Saanlima/Pepino/README.md

# Pepino
**For further information see the Pepino [Wiki](http://www.saanlima.com/pepino/index.php?title=Welcome_to_Pepino).**
