Saanlima/Pepino/Projects/RISC5Verilog_Pepino_I2C/README.md

Oberon RISC5 for Pepino with I2C controller
===========================================

This is a port of the Oberon RISC5 system for the Pepino FPGA board. Both the LX9 and the LX25 version of Pepino are supported.

The original files can be found at the [Project Oberon page](http://www.projectoberon.com/).

Original Project Oberon design and source code copyright © 1991–2015 Niklaus Wirth (NW) and Jürg Gutknecht (JG)

I2C module copyright © 2016 Magnus Karlsson

For further information see the [Pepino Wiki page](http://www.saanlima.com/pepino/index.php?title=Welcome_to_Pepino).

Changes from the original code
------------------------------
- SD card activity LED added
- I2C controller added

Binaries are available in the ISE folder.
