Saanlima/Pepino/Projects/Pepino_NES_smb/doc/NES_connector.jpg

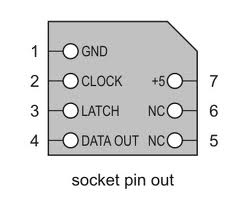
Projects/Pepino_NES_smb/doc/NES_connector.jpg
