Saanlima/Pepino/Board/gerbers_bom/pepino_lx25.xlsx

Pepino LX25 Rev 1.1 BOM
Revision B, 12/08/2015
Line item | Qty | Designators | Description | Package | Type | Manuf. | Part # | DigiKey # | cost | cost for 100 units | Note
1 | 18 | C1 C2 C3 C6 C7 C8 C13 C15 C19 C20 C21 C24 C25 C27 C28 C29 C32 C36 | CAP CER 0.1UF 10V 10% X5R 0402 | C0402 | SMD | Murata | GRM155R61A104KA01D | 490-1318-1-ND | 0.003 | 0.054
2 | 11 | C4 C5 C12 C14 C16 C22 C23 C26 C30 C31 C33 | CAP CER 4.7UF 6.3V 20% X5R 0402 | C0402 | SMD | TDK | C1005X5R0J475M | 445-7395-1-ND | 0.04396 | 0.48356
3 | 2 | C9 C10 | CAP CER 22PF 50V NPO 0402 | C0402 | SMD | Yageo | CC0402JRNPO9BN220 | 311-1018-1-ND | 0.0057 | 0.0114
4 | 2 | C11 C18 | CAP CER 22UF 6.3V 20% X5R 0805 | C0805 | SMD | Taiyo Yuden | JMK212BJ226MG-T | 587-1305-1-ND | 0.112 | 0.224
5 | 1 | C17 | CAP CER 4.7UF 10V X5R 0603 | C0603 | SMD | Yageo | CC0603KRX5R6BB475 | 311-1455-1-ND | 0.0453 | 0.0453
6 | 2 | C34 C35 | CAP CER 4700PF 25V 10% X7R 0402 | C0402 | SMD | Murata | GRM155R71E472KA01D | 490-1309-1-ND | 0.0096 | 0.0192
7 | 1 | F1 | PTC RESTTBLE 0.50A 8V CHIP 1206 | F1206 | SMD | Bel Fuse | 0ZCA0050FF2G | 507-1480-1-ND | 0.1694 | 0.1694
8 | 0 | J1 | Connector Header 8 Position 0.100" Gold Through Hole | MA04-2 | TH | Sullins | PPPC042LFBN-RC | S7107-ND | 0.528 | 0 | Do not mount
9 | 1 | J2 | CONN MINI MICRO-SD 8PIN PCB GOLD | MICRO-SD | SMD | Amphenol | 101-00660-68-6 | 101-00660-68-6-1-ND | 1.4137 | 1.4137
10 | 1 | J3 | CONN JACK STEREO 3.5MM SMD | AUDIO-JACK3 | SMD | Switchcraft | 35RASMT2BHNTRX | SC1489-1-ND | 0.66 | 0.66
11 | 2 | J4 J5 | CONN MINIDIN RECPT UNSHIELD 6POS | MINI-DIN6PTH | TH | CUI | MD-60S | CP-2460-ND | 0.7763 | 1.5526
12 | 1 | J6 | D-Sub Connector, Female 15 Pos Through Hole, Right Angle | DB15H | TH | AMP | 1734344-1 | A35119-ND | 1.04 | 1.04
13 | 1 | J7 | Connector Header 8 Position 0.100" Gold Through Hole | MA04-2 | TH | Sullins | PPPC042LFBN-RC | S7107-ND | 0.528 | 0.528
14 | 1 | J8 | Connector Header 20 Position 0.100" Gold Through Hole | MA10-2 | TH | Sullins | PPPC102LFBN-RC | S6106-ND | 0.9342 | 0.9342
15 | 1 | J9 | CONN RECEPT MINI-USB TYPE B SMT | USB-MINIB-5PIN | SMD | Mill-Max | 897-43-005-00-100001 | ED90341CT-ND | 0.925 | 0.925
16 | 2 | L1 L2 | FERRITE CHIP 600 OHM 200MA 0402 | FB0402 | SMD | Murata | BLM15BD601SN1D | 490-1009-1-ND | 0.047 | 0.094
17 | 1 | L3 | FERRITE CHIP 120 OHM 300MA 0402 | FB0402 | SMD | Murata | BLM15BD121SN1D | 490-5192-1-ND | 0.047 | 0.047
18 | 9 | LD1 LD2 LD3 LD4 LD5 LD6 LD7 LD8 LD9 | LED GREEN CLEAR 0805 SMD | LED0805 | SMD | Lite-On | LTST-C170KGKT | 160-1414-1-ND | 0.06295 | 0.56655
19 | 1 | LD10 | LED SUPER RED CLEAR 0805 SMD | LED0805 | SMD | Lite-On | LTST-C170KRKT | 160-1415-1-ND | 0.1307 | 0.1307
20 | 1 | LD11 | LED YELLOW CLEAR 0805 SMD | LED0805 | SMD | Lite-On | LTST-C170KSKT | 160-1416-1-ND | 0.1307 | 0.1307
21 | 4 | R1 R3 R4 R5 | RES 10.0K OHM 1/10W 1% 0402 SMD | R0402 | SMD | Panasonic | ERJ-2RKF1002X | P10.0KLCT-ND | 0.011 | 0.044
22 | 1 | R2 | RES 12.0K OHM 1/10W 1% 0402 SMD | R0402 | SMD | Panasonic | ERJ-2RKF1202X | P12.0KLCT-ND | 0.011 | 0.011
23 | 1 | R6 | RES 2.20K OHM 1/10W 1% 0402 SMD | R0402 | SMD | Panasonic | ERJ-2RKF2201X | P2.20KLCT-ND | 0.011 | 0.011
24 | 4 | R7 R11 R12 R13 | RES 270 OHM 1/10W 1% 0402 SMD | R0402 | SMD | Panasonic | ERJ-2RKF2700X | P270LCT-ND | 0.011 | 0.044
25 | 3 | R8 R10 R23 | RES 4.70K OHM 1/10W 1% 0402 SMD | R0402 | SMD | Panasonic | ERJ-2RKF4701X | P4.70KLCT-ND | 0.011 | 0.033
26 | 14 | R9 R14 R15 R16 R17 R18 R19 R20 R21 R22 R25 R28 R34 R37 | RES 1.00K OHM 1/10W 1% 0402 SMD | R0402 | SMD | Panasonic | ERJ-2RKF1001X | P1.00KLCT-ND | 0.00496 | 0.06944
27 | 2 | R24 R27 | RES SMD 2K OHM 1% 1/10W 0402 | R0402 | SMD | Panasonic | ERJ-2RKF2001X | P2.00KLCT-ND | 0.011 | 0.022
28 | 2 | R26 R29 | RES 560 OHM 1/10W 1% 0402 SMD | R0402 | SMD | Panasonic | ERJ-2RKF5600X | P560LCT-ND | 0.011 | 0.022
29 | 1 | R30 | RES 820 OHM 1/10W 1% 0402 SMD | R0402 | SMD | Panasonic | ERJ-2RKF8200X | P820LCT-ND | 0.011 | 0.011
30 | 1 | R31 | RES 390 OHM 1/10W 1% 0402 SMD | R0402 | SMD | Panasonic | ERJ-2RKF3900X | P390LCT-ND | 0.011 | 0.011
31 | 2 | R32 R33 | RES 100 OHM 1/10W 1% 0402 SMD | R0402 | SMD | Panasonic | ERJ-2RKF1000X | P100LCT-ND | 0.011 | 0.022
32 | 2 | R35 R36 | RES 3.30K OHM 1/10W 1% 0402 SMD | R0402 | SMD | Panasonic | ERJ-2RKF3301X | P3.30KLCT-ND | 0.011 | 0.022
33 | 1 | S1 | SWITCH DIP SPST EXT ACT 8POS 24V | DIP-SMD | SMD | Alcoswitch | 1-1825058-9 | 1-1825058-9-ND | 0.586 | 0.586
34 | 1 | S2 | SWITCH TACTILE SPST-NO 0.05A 12V | 5.2x5.2 | SMD | C&K | PTS525SM10SMTR LFS | CKN9104CT-ND | 0.513 | 0.513
35 | 1 | U1 | OSCILLATOR 50.0000MHZ SMD | 2.5X2 | SMD | AVX/Kyocera | KC2520B50.0000C10E00 | 478-6302-1-ND | 1.6065 | 1.6065
36 | 1 | U2 | IC FLASH 128MBIT SO8W | SO8-WIDE | SMD | Micron | N25Q128A13ESE40 | N25Q128A13ESE40E-ND | 1.348 | 1.348
37 | 2 | U3 U9 | IC SRAM 8MBIT 10NS 44TSOP | TSOP44 | SMD | ISSI | IS61WV51216BLL-10TLI | 706-1107-ND | 11.5702 | 23.1404
38 | 1 | U4 | IC FPGA 186 I/O 256FTBGA | 6SLX25FTG256 | SMD | Xilinx | XC6SLX25-2FTG256C | 122-1753-ND | 34.02 | 34.02
39 | 1 | U5 | IC REG LDO 3.3V 1A SOT223-3 | SOT223 | SMD | Diodes | ZLDO1117G33TA | ZLDO1117G33DICT-ND | 0.3179 | 0.3179
40 | 1 | U6 | IC REG LDO 1.2V 1A SOT223-3 | SOT223 | SMD | Diodes | ZLDO1117G12TA | ZLDO1117G12DICT-ND | 0.3179 | 0.3179
41 | 1 | U7 | IC USB HS DUAL UART/FIFO 64-LQFP | LQFP64 | SMD | FTDI | FT2232HL-REEL | 768-1024-1-ND | 5.4 | 5.4
42 | 1 | U8 | IC EEPROM 2KBIT 3MHZ SOT23-6 | SOT23-6 | SMD | Microchip | 93LC56BT-I/OT | 93LC56BT-I/OTCT-ND | 0.2 | 0.2
43 | 1 | X1 | CRYSTAL 12.000 MHZ 10PF SMD | 3.2X2.5 | SMD | Abracon | ABM8G-12.000MHZ-4Y-T3 | 535-10901-1-ND | 0.336 | 0.336
 |  |  |  |  |  |  |  |  |  | 77.13745
