Saanlima/Pepino/Board/gerbers_bom/pepino4.TXT

%
M48
M72
T01C0.0118
T02C0.0150
T03C0.0236
T04C0.0354
T05C0.0400
T06C0.0787
T07C0.0866
T08C0.1200
T09C0.1300
%
T01
X3654Y3878
X3969Y3878
X4284Y3878
X4599Y3878
X4914Y3878
X5229Y3878
X6804Y3878
X7119Y3642
X8693Y3878
X9008Y3878
X9323Y3878
X9638Y3878
X9953Y3878
X10268Y3878
X8063Y2540
X5859Y2540
X12276Y6555
X13142Y7815
X12237Y8170
X13024Y8957
X13811Y8957
X13811Y9351
X13811Y9744
X14205Y9744
X14599Y9744
X14599Y9351
X14599Y8957
X14993Y8563
X15386Y8563
X15386Y8957
X15780Y9351
X15780Y9744
X15386Y9744
X15386Y10138
X14993Y10138
X14599Y10138
X14599Y10532
X14205Y10532
X13811Y10532
X13418Y10532
X13024Y10532
X13418Y10925
X13811Y10925
X13811Y11319
X14205Y11319
X13811Y11713
X13418Y11713
X13418Y12107
X13811Y12107
X13811Y12500
X13811Y12894
X13418Y12894
X13024Y12500
X13024Y13288
X13024Y13681
X13418Y13288
X13811Y13288
X13811Y13681
X14205Y13288
X14599Y13288
X14993Y13681
X15386Y13288
X15780Y13288
X15780Y13681
X16174Y13288
X16567Y13681
X16961Y13288
X17355Y13288
X17748Y13288
X18142Y13288
X17748Y14075
X17355Y14075
X18664Y14360
X19126Y15020
X19402Y15335
X19874Y14469
X17355Y12500
X16961Y12500
X16961Y12894
X16567Y12894
X16174Y12894
X15780Y12894
X15780Y12500
X15386Y12500
X14993Y12500
X14993Y12894
X14599Y12894
X14205Y12500
X14599Y11713
X14993Y11713
X15386Y12107
X15780Y11713
X16174Y12107
X16961Y12107
X17355Y12107
X17748Y12107
X16961Y11713
X16567Y11319
X16961Y10925
X17355Y11319
X17748Y11319
X17748Y10925
X18142Y10925
X18142Y11319
X18575Y11319
X19284Y11477
X20465Y11477
X17748Y10532
X17355Y10532
X16961Y10532
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
X13150Y3988
X12150Y3988
X12150Y2988
X13150Y2988
X14150Y2988
X15150Y2988
X16150Y2988
X17150Y2988
X18150Y2988
X19150Y2988
X20150Y2988
X21150Y2988
T06
X27315Y3366
X27315Y6122
T07
X10977Y21398
X5268Y21398
T08
X1134Y2973
X1134Y22264
X38536Y22264
X38536Y2973
T09
X24953Y18768
X15111Y18768
M30
