Saanlima/Pepino/Board/eagle/pepino4.brd

## EAGLE design Board/eagle/pepino4.brd (2020-05-03)

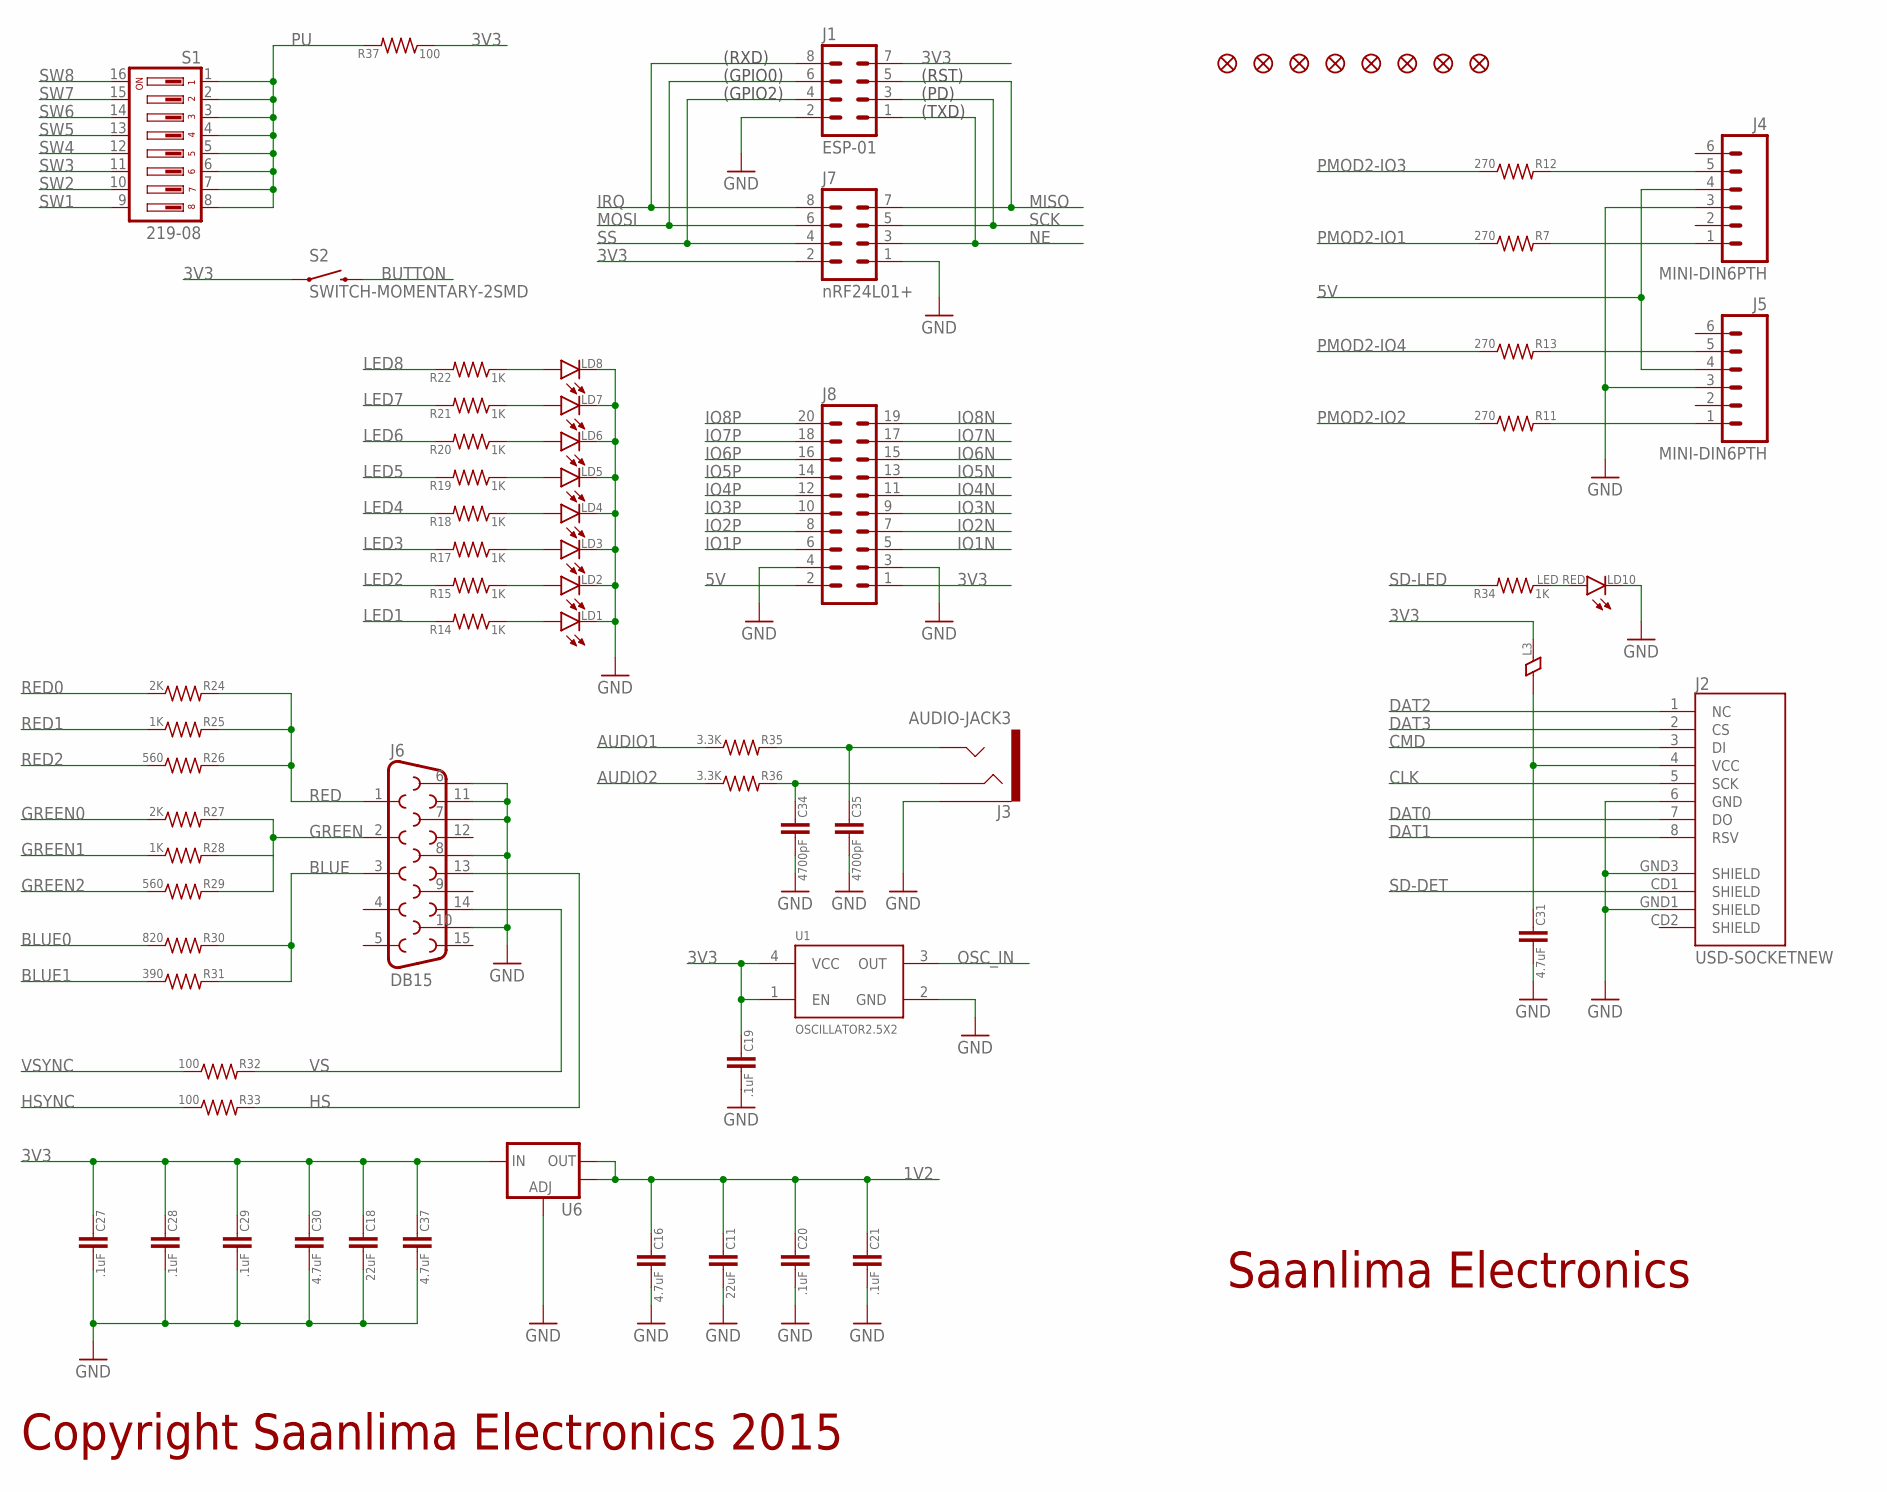
[picture p6: schematic pepino4.sch, sheet 1]

Parts:
C11, C18: 22uF; 0805
C16, C30, C31, C37: 4.7uF; 0402
C19, C20, C21, C27, C28, C29: .1uF; 0402
C34, C35: 4700pF; 0402
J1: ESP-01; MA04-2
J2: USD-SOCKETNEW; MICRO-SD-SOCKET-PP
J3: AUDIO-JACK3; AUDIO-JACK-3.5MM-3
J4, J5: MINI-DIN6PTH; MINI-DIN6
J6: DB15
J7: nRF24L01+; MA04-2
J8: MA10-2
JP1, JP2, JP3, JP4, JP5, JP6, JP7, JP8: FIDUCIAL1X2; FIDUCIAL-1X2
L3: FERRITE0402; 0402
LD1, LD2, LD3, LD4, LD5, LD6, LD7, LD8: LED0805; 0805_POL
LD10: LED RED; 0805_POL
R7, R11, R12, R13: 270; 0402
R14, R15, R17, R18, R19, R20, R21, R22, R25, R28, R34: 1K; 0402
R24, R27: 2K; 0402
R26, R29: 560; 0402
R30: 820; 0402
R31: 390; 0402
R32, R33, R37: 100; 0402
R35, R36: 3.3K; 0402
S1: 219-08; CTS-219-08
S2: SWITCH-MOMENTARY-2SMD; TACTILE_SWITCH_SMD
U1: OSCILLATOR2.5X2; CRYSTAL-OSC-SMD-2.5X2
U6: V_REG_LM1117SOT223; SOT223

Connections:
1V2: C11.1, C16.1, C20.1, C21.1, U6.2 (OUT), U6.4 (OUT); also elsewhere on the board
3V3: C18.1, C19.1, C27.1, C28.1, C29.1, C30.1, C37.1, J1.7, J7.2, J8.1, L3.2, R37.1, S2.1, U1.1 (EN), U1.4 (VCC), U6.3 (IN); also elsewhere on the board
5V: J4.4, J5.4, J8.2; also elsewhere on the board
AUDIO1: R35.1; also elsewhere on the board
AUDIO2: R36.1; also elsewhere on the board
BLUE: J6.3, R30.2, R31.2
BLUE0: R30.1; also elsewhere on the board
BLUE1: R31.1; also elsewhere on the board
BUTTON: S2.3 (2); also elsewhere on the board
CLK: J2.5 (SCK); also elsewhere on the board
CMD: J2.3 (DI); also elsewhere on the board
DAT0: J2.7 (DO); also elsewhere on the board
DAT1: J2.8 (RSV); also elsewhere on the board
DAT2: J2.1 (NC); also elsewhere on the board
DAT3: J2.2 (CS); also elsewhere on the board
GND: C11.2, C16.2, C18.2, C19.2, C20.2, C21.2, C27.2, C28.2, C29.2, C30.2, C31.2, C34.2, C35.2, C37.2, J1.2, J2.6 (GND), J2.GND1 (SHIELD), J2.GND3 (SHIELD), J3.SLEEVE, J4.3, J5.3, J6.6, J6.7, J6.8, J6.10, J6.11, J7.1, J8.3, J8.4, LD1.- (C), LD2.- (C), LD3.- (C), LD4.- (C), LD5.- (C), LD6.- (C), LD7.- (C), LD8.- (C), LD10.- (C), U1.2 (GND), U6.1 (ADJ); also elsewhere on the board
GREEN: J6.2, R27.2, R28.2, R29.2
GREEN0: R27.1; also elsewhere on the board
GREEN1: R28.1; also elsewhere on the board
GREEN2: R29.1; also elsewhere on the board
HS: J6.13, R33.2
HSYNC: R33.1; also elsewhere on the board
IO1N: J8.5; also elsewhere on the board
IO1P: J8.6; also elsewhere on the board
IO2N: J8.7; also elsewhere on the board
IO2P: J8.8; also elsewhere on the board
IO3N: J8.9; also elsewhere on the board
IO3P: J8.10; also elsewhere on the board
IO4N: J8.11; also elsewhere on the board
IO4P: J8.12; also elsewhere on the board
IO5N: J8.13; also elsewhere on the board
IO5P: J8.14; also elsewhere on the board
IO6N: J8.15; also elsewhere on the board
IO6P: J8.16; also elsewhere on the board
IO7N: J8.17; also elsewhere on the board
IO7P: J8.18; also elsewhere on the board
IO8N: J8.19; also elsewhere on the board
IO8P: J8.20; also elsewhere on the board
IRQ: J1.8, J7.8; also elsewhere on the board
LED1: R14.2; also elsewhere on the board
LED2: R15.2; also elsewhere on the board
LED3: R17.2; also elsewhere on the board
LED4: R18.2; also elsewhere on the board
LED5: R19.2; also elsewhere on the board
LED6: R20.2; also elsewhere on the board
LED7: R21.2; also elsewhere on the board
LED8: R22.2; also elsewhere on the board
MISO: J1.5, J7.7; also elsewhere on the board
MOSI: J1.6, J7.6; also elsewhere on the board
unnamed: J4.1, R7.2
unnamed: J5.1, R11.2
unnamed: J4.5, R12.2
unnamed: C31.1, J2.4 (VCC), L3.1
unnamed: J5.5, R13.2
unnamed: LD1.+ (A), R14.1
unnamed: LD7.+ (A), R21.1
unnamed: LD2.+ (A), R15.1
unnamed: LD3.+ (A), R17.1
unnamed: LD4.+ (A), R18.1
unnamed: LD5.+ (A), R19.1
unnamed: LD6.+ (A), R20.1
unnamed: LD8.+ (A), R22.1
unnamed: LD10.+ (A), R34.1
unnamed: C34.1, J3.RING, R36.2
unnamed: C35.1, J3.TIP, R35.2
NE: J1.1, J7.3; also elsewhere on the board
OSC_IN: U1.3 (OUT); also elsewhere on the board
PMOD2-IO1: R7.1; also elsewhere on the board
PMOD2-IO2: R11.1; also elsewhere on the board
PMOD2-IO3: R12.1; also elsewhere on the board
PMOD2-IO4: R13.1; also elsewhere on the board
PU: R37.2, S1.1, S1.2, S1.3, S1.4, S1.5, S1.6, S1.7, S1.8
RED: J6.1, R24.2, R25.2, R26.2
RED0: R24.1; also elsewhere on the board
RED1: R25.1; also elsewhere on the board
RED2: R26.1; also elsewhere on the board
SCK: J1.3, J7.5; also elsewhere on the board
SD-DET: J2.CD1 (SHIELD); also elsewhere on the board
SD-LED: R34.2; also elsewhere on the board
SS: J1.4, J7.4; also elsewhere on the board
SW1: S1.9; also elsewhere on the board
SW2: S1.10; also elsewhere on the board
SW3: S1.11; also elsewhere on the board
SW4: S1.12; also elsewhere on the board
SW5: S1.13; also elsewhere on the board
SW6: S1.14; also elsewhere on the board
SW7: S1.15; also elsewhere on the board
SW8: S1.16; also elsewhere on the board
VS: J6.14, R32.2
VSYNC: R32.1; also elsewhere on the board

Notes on the sheet:
(RST)
(PD)
(TXD)
(RXD)
(GPIO0)
(GPIO2)
Saanlima Electronics
Copyright Saanlima Electronics 2015

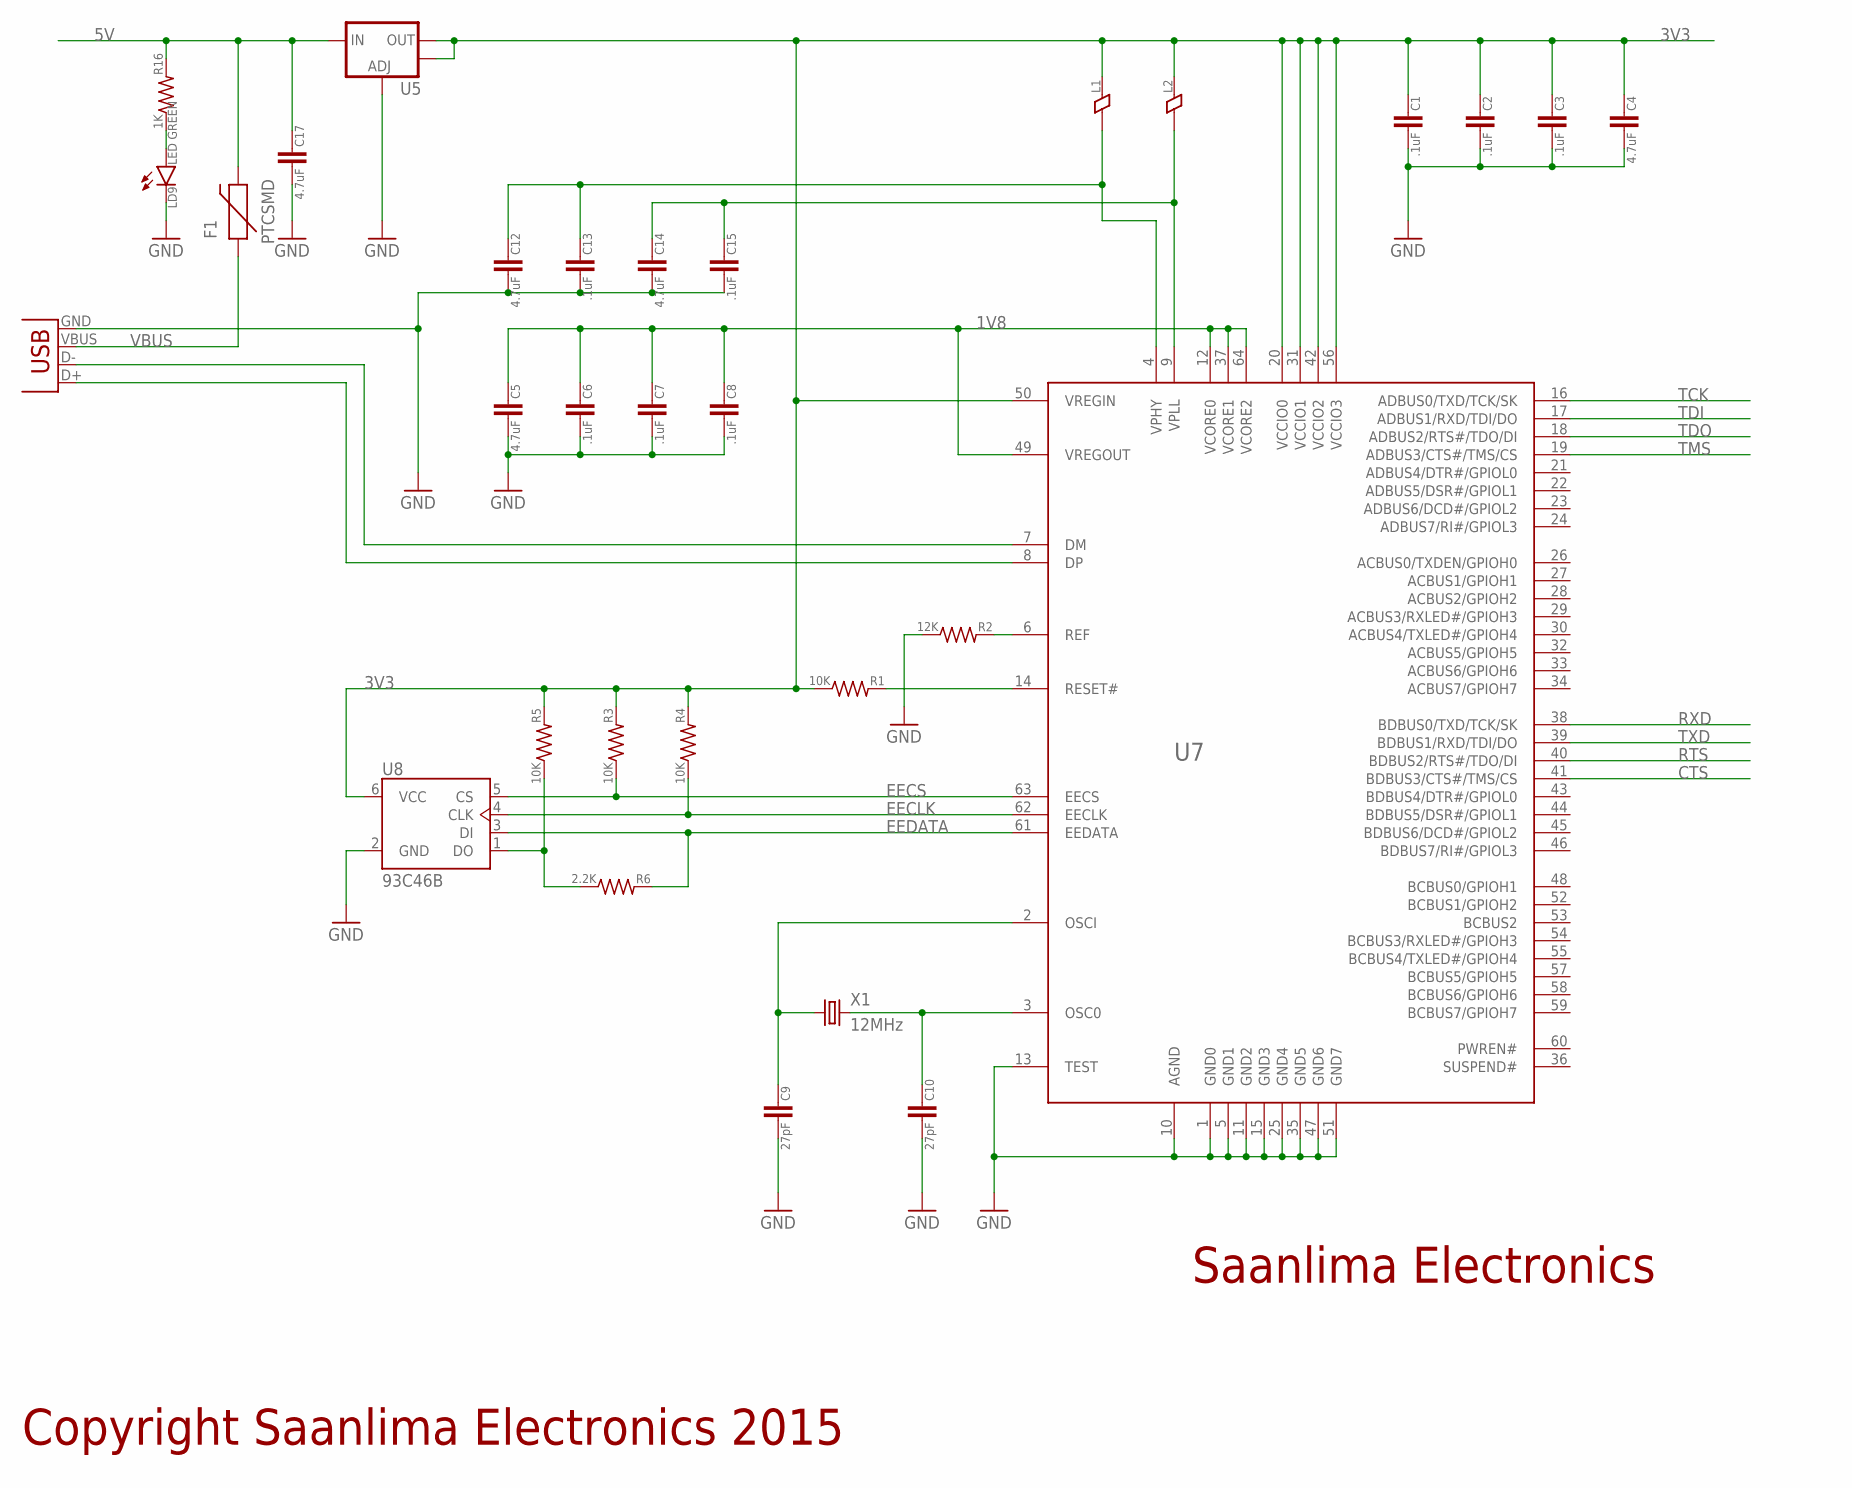
[picture p7: schematic pepino4.sch, sheet 2]

Parts:
C1, C2, C3, C6, C7, C8, C13, C15: .1uF; 0402
C4, C5, C12, C14: 4.7uF; 0402
C9, C10: 27pF; 0402
C17: 4.7uF; 0603
F1: PTCSMD; PTC-1206
J9: USBSMD; USB-MINIB
L1, L2: FERRITE0402; 0402
LD9: LED GREEN; 0805_POL
R1, R3, R4, R5: 10K; 0402
R2: 12K; 0402
R6: 2.2K; 0402
R16: 1K; 0402
U5: V_REG_LM1117SOT223; SOT223
U7: DP-EAGLELIBRARY_FT2232H; DP-EAGLELIBRARY_LQFP64
U8: 93C46B; SOT23-6
X1: 12MHz; CRYSTAL3.2X2.5MM

Connections:
1V8: C5.1, C6.1, C7.1, C8.1, U7.12 (VCORE0), U7.37 (VCORE1), U7.49 (VREGOUT), U7.64 (VCORE2)
3V3: C1.1, C2.1, C3.1, C4.1, L1.2, L2.2, R1.1, R3.2, R4.2, R5.2, U5.2 (OUT), U5.4 (OUT), U7.20 (VCCIO0), U7.31 (VCCIO1), U7.42 (VCCIO2), U7.50 (VREGIN), U7.56 (VCCIO3), U8.6 (VCC); also elsewhere on the board
5V: C17.1, F1.2, R16.2, U5.3 (IN); also elsewhere on the board
CTS: U7.41 (BDBUS3/CTS#/TMS/CS); also elsewhere on the board
EECLK: R4.1, U7.62 (EECLK), U8.4 (CLK)
EECS: R3.1, U7.63 (EECS), U8.5 (CS)
EEDATA: R6.2, U7.61 (EEDATA), U8.3 (DI)
GND: C1.2, C2.2, C3.2, C4.2, C5.2, C6.2, C7.2, C8.2, C9.2, C10.2, C12.2, C13.2, C14.2, C15.2, C17.2, J9.GND, LD9.- (C), R2.1, U5.1 (ADJ), U7.1 (GND0), U7.5 (GND1), U7.10 (AGND), U7.11 (GND2), U7.13 (TEST), U7.15 (GND3), U7.25 (GND4), U7.35 (GND5), U7.47 (GND6), U7.51 (GND7), U8.2 (GND); also elsewhere on the board
unnamed: C9.1, U7.2 (OSCI), X1.1
unnamed: C10.1, U7.3 (OSC0), X1.3 (2)
unnamed: LD9.+ (A), R16.1
unnamed: J9.D-, U7.7 (DM)
unnamed: J9.D+, U7.8 (DP)
unnamed: C14.1, C15.1, L2.1, U7.9 (VPLL)
unnamed: R1.2, U7.14 (RESET#)
unnamed: R2.2, U7.6 (REF)
unnamed: C12.1, C13.1, L1.1, U7.4 (VPHY)
unnamed: R5.1, R6.1, U8.1 (DO)
RTS: U7.40 (BDBUS2/RTS#/TDO/DI); also elsewhere on the board
RXD: U7.38 (BDBUS0/TXD/TCK/SK); also elsewhere on the board
TCK: U7.16 (ADBUS0/TXD/TCK/SK); also elsewhere on the board
TDI: U7.17 (ADBUS1/RXD/TDI/DO); also elsewhere on the board
TDO: U7.18 (ADBUS2/RTS#/TDO/DI); also elsewhere on the board
TMS: U7.19 (ADBUS3/CTS#/TMS/CS); also elsewhere on the board
TXD: U7.39 (BDBUS1/RXD/TDI/DO); also elsewhere on the board
VBUS: F1.1, J9.VBUS

Notes on the sheet:
Copyright Saanlima Electronics 2015
Saanlima Electronics

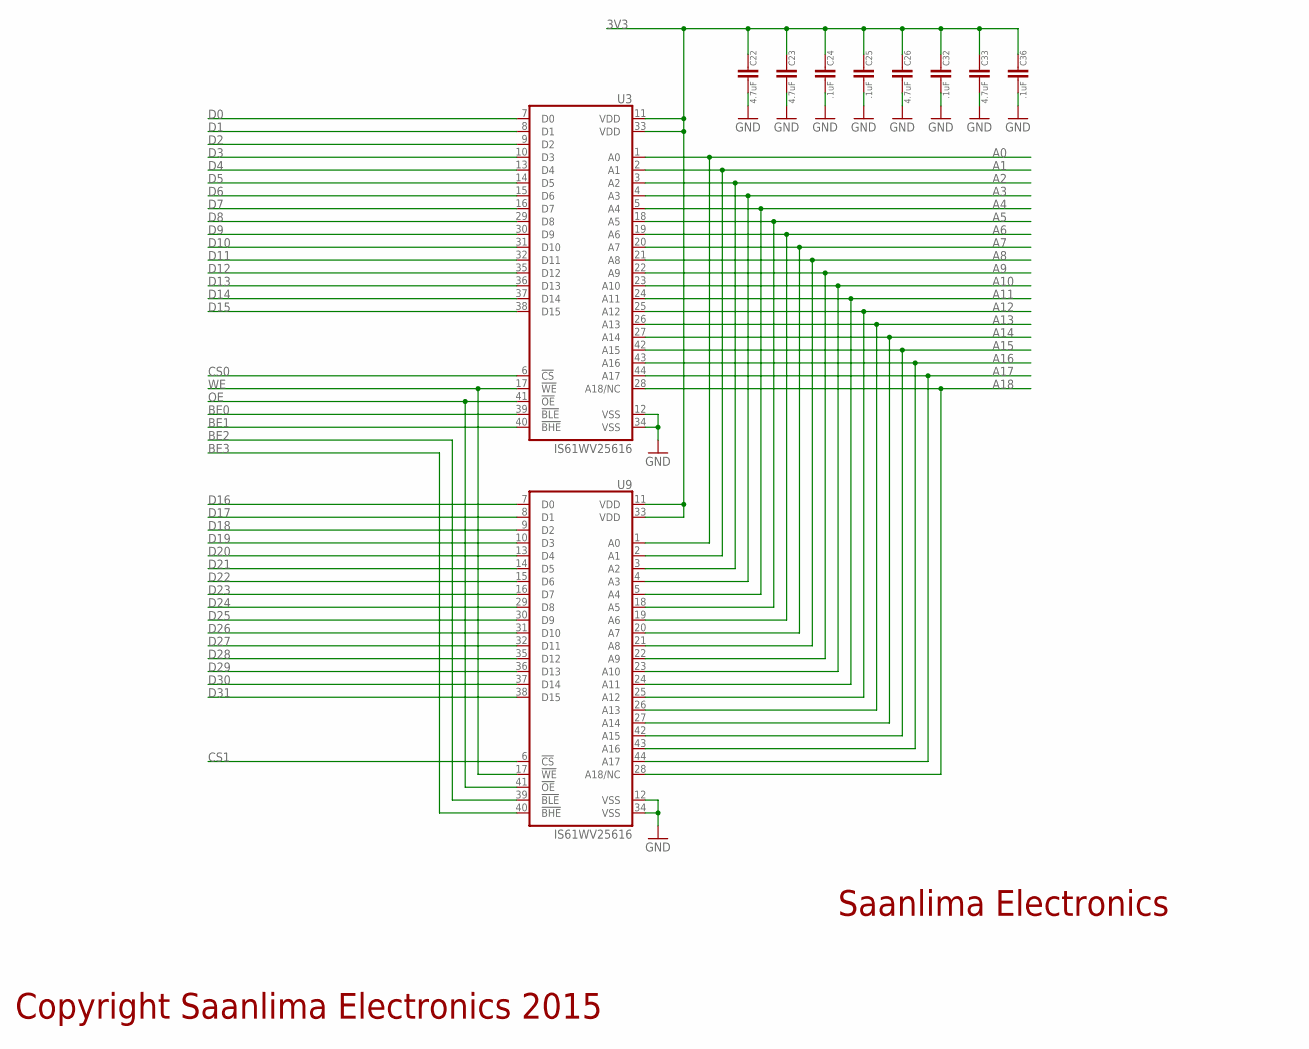
[picture p8: schematic pepino4.sch, sheet 3]

Parts:
C22, C23, C26, C33: 4.7uF; 0402
C24, C25, C32, C36: .1uF; 0402
U3, U9: IS61WV25616; TSOP44-II

Connections:
3V3: C22.1, C23.1, C24.1, C25.1, C26.1, C32.1, C33.1, C36.1, U3.11 (VDD), U3.33 (VDD), U9.11 (VDD), U9.33 (VDD); also elsewhere on the board
A0: U3.1 (A0), U9.1 (A0); also elsewhere on the board
A1: U3.2 (A1), U9.2 (A1); also elsewhere on the board
A2: U3.3 (A2), U9.3 (A2); also elsewhere on the board
A3: U3.4 (A3), U9.4 (A3); also elsewhere on the board
A4: U3.5 (A4), U9.5 (A4); also elsewhere on the board
A5: U3.18 (A5), U9.18 (A5); also elsewhere on the board
A6: U3.19 (A6), U9.19 (A6); also elsewhere on the board
A7: U3.20 (A7), U9.20 (A7); also elsewhere on the board
A8: U3.21 (A8), U9.21 (A8); also elsewhere on the board
A9: U3.22 (A9), U9.22 (A9); also elsewhere on the board
A10: U3.23 (A10), U9.23 (A10); also elsewhere on the board
A11: U3.24 (A11), U9.24 (A11); also elsewhere on the board
A12: U3.25 (A12), U9.25 (A12); also elsewhere on the board
A13: U3.26 (A13), U9.26 (A13); also elsewhere on the board
A14: U3.27 (A14), U9.27 (A14); also elsewhere on the board
A15: U3.42 (A15), U9.42 (A15); also elsewhere on the board
A16: U3.43 (A16), U9.43 (A16); also elsewhere on the board
A17: U3.44 (A17), U9.44 (A17); also elsewhere on the board
A18: U3.28 (A18/NC), U9.28 (A18/NC); also elsewhere on the board
BE0: U3.39 (!BLE); also elsewhere on the board
BE1: U3.40 (!BHE); also elsewhere on the board
BE2: U9.39 (!BLE); also elsewhere on the board
BE3: U9.40 (!BHE); also elsewhere on the board
CS0: U3.6 (!CS); also elsewhere on the board
CS1: U9.6 (!CS); also elsewhere on the board
D0: U3.7 (D0); also elsewhere on the board
D1: U3.8 (D1); also elsewhere on the board
D2: U3.9 (D2); also elsewhere on the board
D3: U3.10 (D3); also elsewhere on the board
D4: U3.13 (D4); also elsewhere on the board
D5: U3.14 (D5); also elsewhere on the board
D6: U3.15 (D6); also elsewhere on the board
D7: U3.16 (D7); also elsewhere on the board
D8: U3.29 (D8); also elsewhere on the board
D9: U3.30 (D9); also elsewhere on the board
D10: U3.31 (D10); also elsewhere on the board
D11: U3.32 (D11); also elsewhere on the board
D12: U3.35 (D12); also elsewhere on the board
D13: U3.36 (D13); also elsewhere on the board
D14: U3.37 (D14); also elsewhere on the board
D15: U3.38 (D15); also elsewhere on the board
D16: U9.7 (D0); also elsewhere on the board
D17: U9.8 (D1); also elsewhere on the board
D18: U9.9 (D2); also elsewhere on the board
D19: U9.10 (D3); also elsewhere on the board
D20: U9.13 (D4); also elsewhere on the board
D21: U9.14 (D5); also elsewhere on the board
D22: U9.15 (D6); also elsewhere on the board
D23: U9.16 (D7); also elsewhere on the board
D24: U9.29 (D8); also elsewhere on the board
D25: U9.30 (D9); also elsewhere on the board
D26: U9.31 (D10); also elsewhere on the board
D27: U9.32 (D11); also elsewhere on the board
D28: U9.35 (D12); also elsewhere on the board
D29: U9.36 (D13); also elsewhere on the board
D30: U9.37 (D14); also elsewhere on the board
D31: U9.38 (D15); also elsewhere on the board
GND: C22.2, C23.2, C24.2, C25.2, C26.2, C32.2, C33.2, C36.2, U3.12 (VSS), U3.34 (VSS), U9.12 (VSS), U9.34 (VSS); also elsewhere on the board
OE: U3.41 (!OE), U9.41 (!OE); also elsewhere on the board
WE: U3.17 (!WE), U9.17 (!WE); also elsewhere on the board

Notes on the sheet:
Copyright Saanlima Electronics 2015
Saanlima Electronics

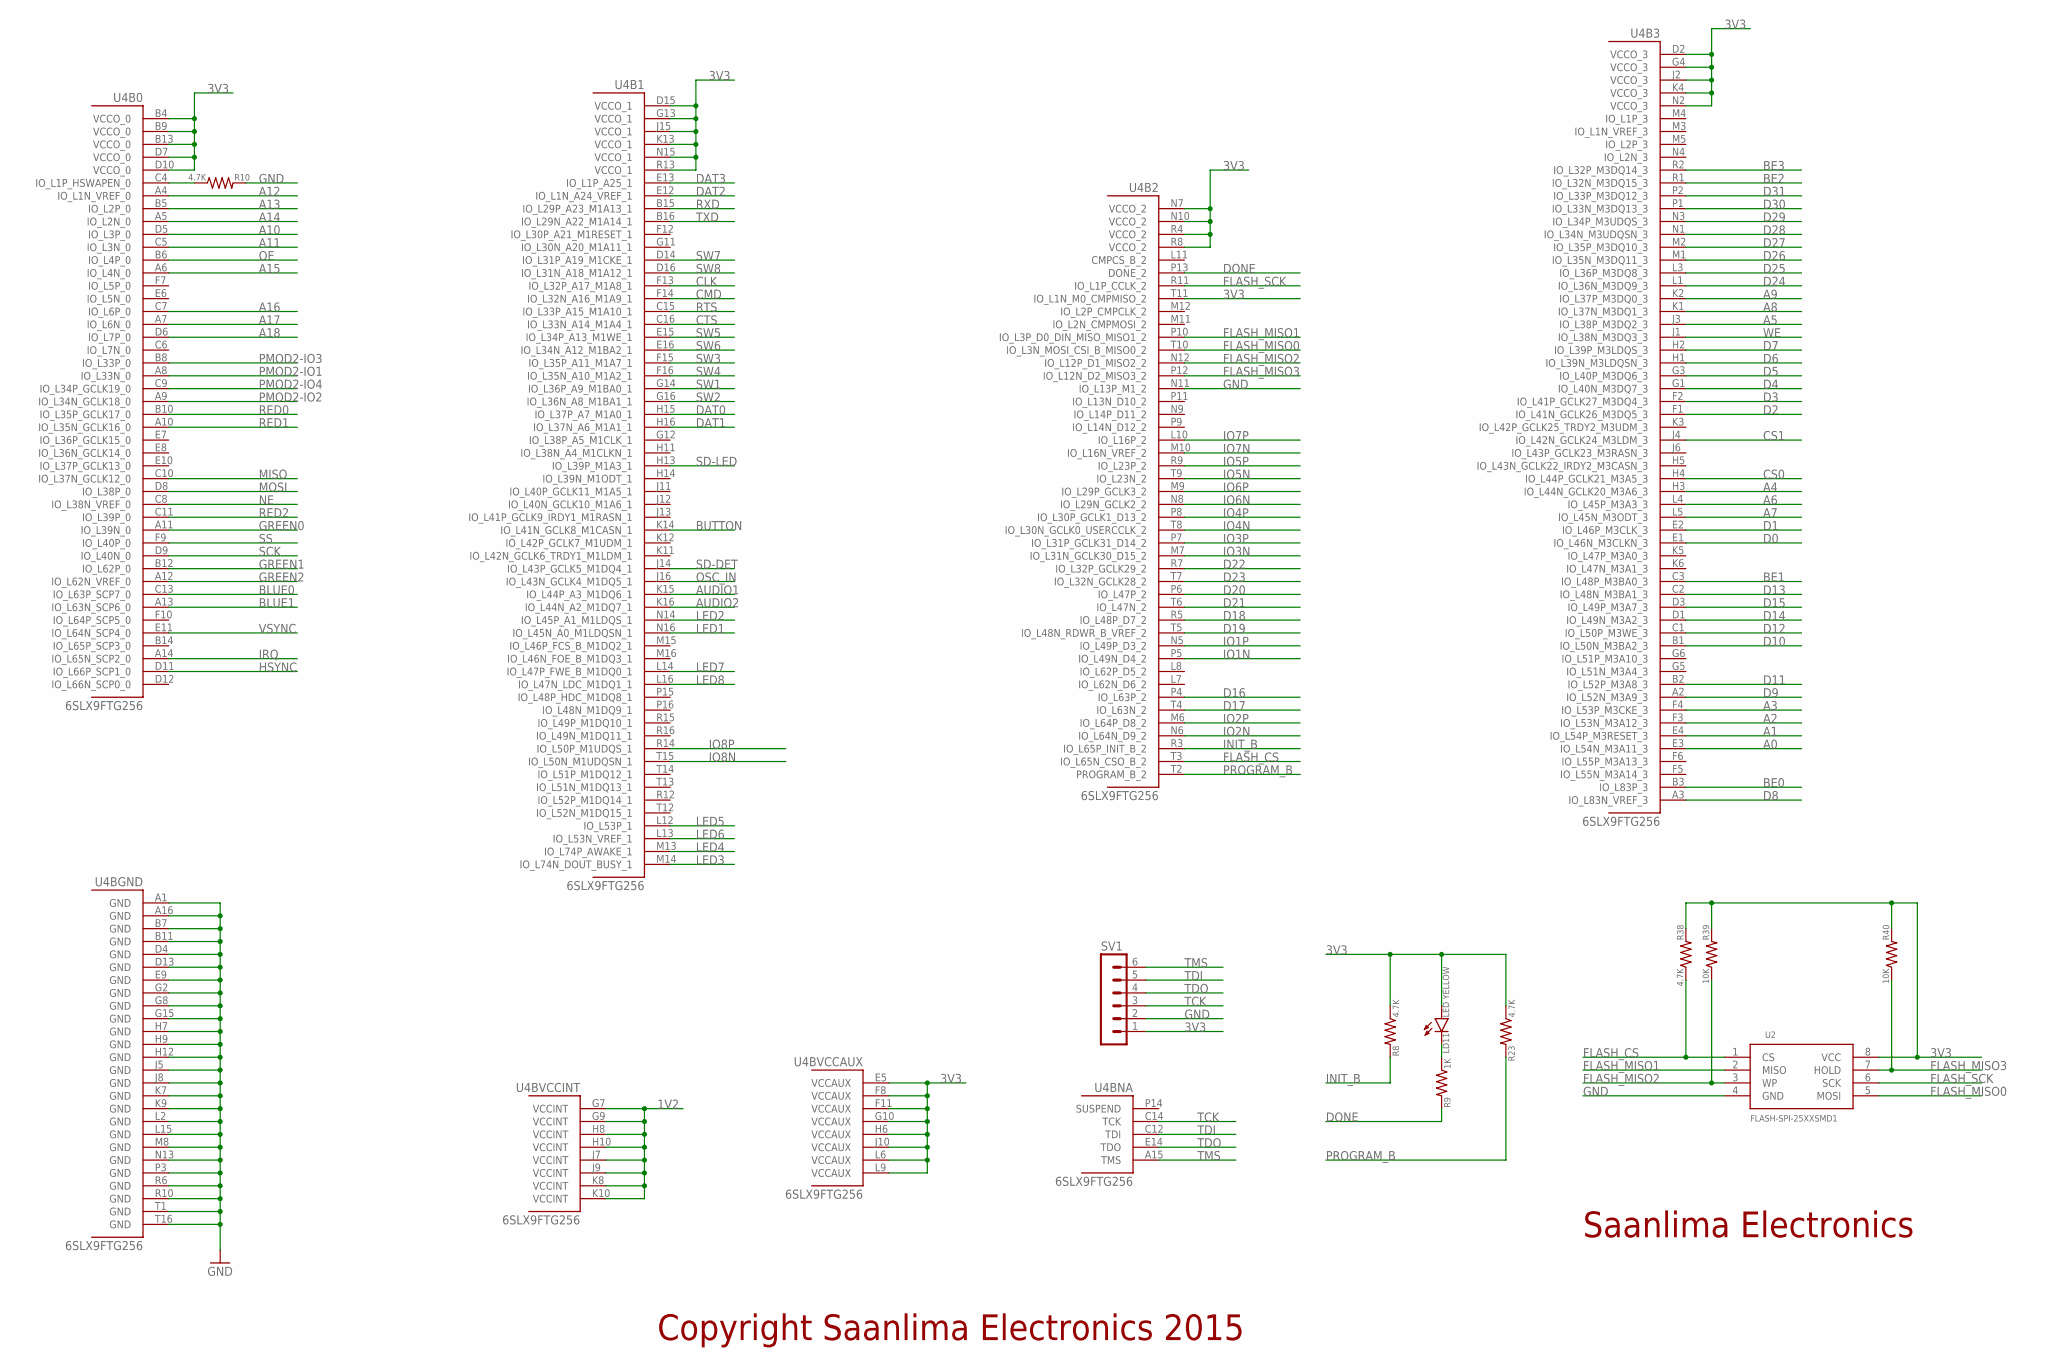
[picture p9: schematic pepino4.sch, sheet 4]

Parts:
LD11: LED YELLOW; 0805_POL
R8, R10, R23, R38: 4.7K; 0402
R9: 1K; 0402
R39, R40: 10K; 0402
SV1: MA06-1
U2: FLASH-SPI-25XXSMD1; SO08-EIAJ
U4: 6SLX9FTG256; FT256

Connections:
1V2: U4.G7 (VCCINT), U4.G9 (VCCINT), U4.H8 (VCCINT), U4.H10 (VCCINT), U4.J7 (VCCINT), U4.J9 (VCCINT), U4.K8 (VCCINT), U4.K10 (VCCINT); also elsewhere on the board
3V3: LD11.+ (A), R8.1, R23.1, R38.2, R39.2, R40.2, SV1.1, U2.8 (VCC), U4.B4 (VCCO_0), U4.B9 (VCCO_0), U4.B13 (VCCO_0), U4.D2 (VCCO_3), U4.D7 (VCCO_0), U4.D10 (VCCO_0), U4.D15 (VCCO_1), U4.E5 (VCCAUX), U4.F8 (VCCAUX), U4.F11 (VCCAUX), U4.G4 (VCCO_3), U4.G10 (VCCAUX), U4.G13 (VCCO_1), U4.H6 (VCCAUX), U4.J2 (VCCO_3), U4.J10 (VCCAUX), U4.J15 (VCCO_1), U4.K4 (VCCO_3), U4.K13 (VCCO_1), U4.L6 (VCCAUX), U4.L9 (VCCAUX), U4.N2 (VCCO_3), U4.N7 (VCCO_2), U4.N10 (VCCO_2), U4.N15 (VCCO_1), U4.R4 (VCCO_2), U4.R8 (VCCO_2), U4.R13 (VCCO_1), U4.T11 (IO_L1N_M0_CMPMISO_2); also elsewhere on the board
A0: U4.E3 (IO_L54N_M3A11_3); also elsewhere on the board
A1: U4.E4 (IO_L54P_M3RESET_3); also elsewhere on the board
A2: U4.F3 (IO_L53N_M3A12_3); also elsewhere on the board
A3: U4.F4 (IO_L53P_M3CKE_3); also elsewhere on the board
A4: U4.H3 (IO_L44N_GCLK20_M3A6_3); also elsewhere on the board
A5: U4.J3 (IO_L38P_M3DQ2_3); also elsewhere on the board
A6: U4.L4 (IO_L45P_M3A3_3); also elsewhere on the board
A7: U4.L5 (IO_L45N_M3ODT_3); also elsewhere on the board
A8: U4.K1 (IO_L37N_M3DQ1_3); also elsewhere on the board
A9: U4.K2 (IO_L37P_M3DQ0_3); also elsewhere on the board
A10: U4.D5 (IO_L3P_0); also elsewhere on the board
A11: U4.C5 (IO_L3N_0); also elsewhere on the board
A12: U4.A4 (IO_L1N_VREF_0); also elsewhere on the board
A13: U4.B5 (IO_L2P_0); also elsewhere on the board
A14: U4.A5 (IO_L2N_0); also elsewhere on the board
A15: U4.A6 (IO_L4N_0); also elsewhere on the board
A16: U4.C7 (IO_L6P_0); also elsewhere on the board
A17: U4.A7 (IO_L6N_0); also elsewhere on the board
A18: U4.D6 (IO_L7P_0); also elsewhere on the board
AUDIO1: U4.K15 (IO_L44P_A3_M1DQ6_1); also elsewhere on the board
AUDIO2: U4.K16 (IO_L44N_A2_M1DQ7_1); also elsewhere on the board
BE0: U4.B3 (IO_L83P_3); also elsewhere on the board
BE1: U4.C3 (IO_L48P_M3BA0_3); also elsewhere on the board
BE2: U4.R1 (IO_L32N_M3DQ15_3); also elsewhere on the board
BE3: U4.R2 (IO_L32P_M3DQ14_3); also elsewhere on the board
BLUE0: U4.C13 (IO_L63P_SCP7_0); also elsewhere on the board
BLUE1: U4.A13 (IO_L63N_SCP6_0); also elsewhere on the board
BUTTON: U4.K14 (IO_L41N_GCLK8_M1CASN_1); also elsewhere on the board
CLK: U4.F13 (IO_L32P_A17_M1A8_1); also elsewhere on the board
CMD: U4.F14 (IO_L32N_A16_M1A9_1); also elsewhere on the board
CS0: U4.H4 (IO_L44P_GCLK21_M3A5_3); also elsewhere on the board
CS1: U4.J4 (IO_L42N_GCLK24_M3LDM_3); also elsewhere on the board
CTS: U4.C16 (IO_L33N_A14_M1A4_1); also elsewhere on the board
D0: U4.E1 (IO_L46N_M3CLKN_3); also elsewhere on the board
D1: U4.E2 (IO_L46P_M3CLK_3); also elsewhere on the board
D2: U4.F1 (IO_L41N_GCLK26_M3DQ5_3); also elsewhere on the board
D3: U4.F2 (IO_L41P_GCLK27_M3DQ4_3); also elsewhere on the board
D4: U4.G1 (IO_L40N_M3DQ7_3); also elsewhere on the board
D5: U4.G3 (IO_L40P_M3DQ6_3); also elsewhere on the board
D6: U4.H1 (IO_L39N_M3LDQSN_3); also elsewhere on the board
D7: U4.H2 (IO_L39P_M3LDQS_3); also elsewhere on the board
D8: U4.A3 (IO_L83N_VREF_3); also elsewhere on the board
D9: U4.A2 (IO_L52N_M3A9_3); also elsewhere on the board
D10: U4.B1 (IO_L50N_M3BA2_3); also elsewhere on the board
D11: U4.B2 (IO_L52P_M3A8_3); also elsewhere on the board
D12: U4.C1 (IO_L50P_M3WE_3); also elsewhere on the board
D13: U4.C2 (IO_L48N_M3BA1_3); also elsewhere on the board
D14: U4.D1 (IO_L49N_M3A2_3); also elsewhere on the board
D15: U4.D3 (IO_L49P_M3A7_3); also elsewhere on the board
D16: U4.P4 (IO_L63P_2); also elsewhere on the board
D17: U4.T4 (IO_L63N_2); also elsewhere on the board
D18: U4.R5 (IO_L48P_D7_2); also elsewhere on the board
D19: U4.T5 (IO_L48N_RDWR_B_VREF_2); also elsewhere on the board
D20: U4.P6 (IO_L47P_2); also elsewhere on the board
D21: U4.T6 (IO_L47N_2); also elsewhere on the board
D22: U4.R7 (IO_L32P_GCLK29_2); also elsewhere on the board
D23: U4.T7 (IO_L32N_GCLK28_2); also elsewhere on the board
D24: U4.L1 (IO_L36N_M3DQ9_3); also elsewhere on the board
D25: U4.L3 (IO_L36P_M3DQ8_3); also elsewhere on the board
D26: U4.M1 (IO_L35N_M3DQ11_3); also elsewhere on the board
D27: U4.M2 (IO_L35P_M3DQ10_3); also elsewhere on the board
D28: U4.N1 (IO_L34N_M3UDQSN_3); also elsewhere on the board
D29: U4.N3 (IO_L34P_M3UDQS_3); also elsewhere on the board
D30: U4.P1 (IO_L33N_M3DQ13_3); also elsewhere on the board
D31: U4.P2 (IO_L33P_M3DQ12_3); also elsewhere on the board
DAT0: U4.H15 (IO_L37P_A7_M1A0_1); also elsewhere on the board
DAT1: U4.H16 (IO_L37N_A6_M1A1_1); also elsewhere on the board
DAT2: U4.E12 (IO_L1N_A24_VREF_1); also elsewhere on the board
DAT3: U4.E13 (IO_L1P_A25_1); also elsewhere on the board
DONE: R9.2, U4.P13 (DONE_2)
FLASH_CS: R38.1, U2.1 (CS), U4.T3 (IO_L65N_CSO_B_2)
FLASH_MISO0: U2.5 (MOSI), U4.T10 (IO_L3N_MOSI_CSI_B_MISO0_2)
FLASH_MISO1: U2.2 (MISO), U4.P10 (IO_L3P_D0_DIN_MISO_MISO1_2)
FLASH_MISO2: R39.1, U2.3 (WP), U4.N12 (IO_L12P_D1_MISO2_2)
FLASH_MISO3: R40.1, U2.7 (HOLD), U4.P12 (IO_L12N_D2_MISO3_2)
FLASH_SCK: U2.6 (SCK), U4.R11 (IO_L1P_CCLK_2)
GND: R10.2, SV1.2, U2.4 (GND), U4.A1 (GND), U4.A16 (GND), U4.B7 (GND), U4.B11 (GND), U4.D4 (GND), U4.D13 (GND), U4.E9 (GND), U4.G2 (GND), U4.G8 (GND), U4.G15 (GND), U4.H7 (GND), U4.H9 (GND), U4.H12 (GND), U4.J5 (GND), U4.J8 (GND), U4.K7 (GND), U4.K9 (GND), U4.L2 (GND), U4.L15 (GND), U4.M8 (GND), U4.N11 (IO_L13P_M1_2), U4.N13 (GND), U4.P3 (GND), U4.R6 (GND), U4.R10 (GND), U4.T1 (GND), U4.T16 (GND); also elsewhere on the board
GREEN0: U4.A11 (IO_L39N_0); also elsewhere on the board
GREEN1: U4.B12 (IO_L62P_0); also elsewhere on the board
GREEN2: U4.A12 (IO_L62N_VREF_0); also elsewhere on the board
HSYNC: U4.D11 (IO_L66P_SCP1_0); also elsewhere on the board
INIT_B: R8.2, U4.R3 (IO_L65P_INIT_B_2)
IO1N: U4.P5 (IO_L49N_D4_2); also elsewhere on the board
IO1P: U4.N5 (IO_L49P_D3_2); also elsewhere on the board
IO2N: U4.N6 (IO_L64N_D9_2); also elsewhere on the board
IO2P: U4.M6 (IO_L64P_D8_2); also elsewhere on the board
IO3N: U4.M7 (IO_L31N_GCLK30_D15_2); also elsewhere on the board
IO3P: U4.P7 (IO_L31P_GCLK31_D14_2); also elsewhere on the board
IO4N: U4.T8 (IO_L30N_GCLK0_USERCCLK_2); also elsewhere on the board
IO4P: U4.P8 (IO_L30P_GCLK1_D13_2); also elsewhere on the board
IO5N: U4.T9 (IO_L23N_2); also elsewhere on the board
IO5P: U4.R9 (IO_L23P_2); also elsewhere on the board
IO6N: U4.N8 (IO_L29N_GCLK2_2); also elsewhere on the board
IO6P: U4.M9 (IO_L29P_GCLK3_2); also elsewhere on the board
IO7N: U4.M10 (IO_L16N_VREF_2); also elsewhere on the board
IO7P: U4.L10 (IO_L16P_2); also elsewhere on the board
IO8N: U4.T15 (IO_L50N_M1UDQSN_1); also elsewhere on the board
IO8P: U4.R14 (IO_L50P_M1UDQS_1); also elsewhere on the board
IRQ: U4.A14 (IO_L65N_SCP2_0); also elsewhere on the board
LED1: U4.N16 (IO_L45N_A0_M1LDQSN_1); also elsewhere on the board
LED2: U4.N14 (IO_L45P_A1_M1LDQS_1); also elsewhere on the board
LED3: U4.M14 (IO_L74N_DOUT_BUSY_1); also elsewhere on the board
LED4: U4.M13 (IO_L74P_AWAKE_1); also elsewhere on the board
LED5: U4.L12 (IO_L53P_1); also elsewhere on the board
LED6: U4.L13 (IO_L53N_VREF_1); also elsewhere on the board
LED7: U4.L14 (IO_L47P_FWE_B_M1DQ0_1); also elsewhere on the board
LED8: U4.L16 (IO_L47N_LDC_M1DQ1_1); also elsewhere on the board
MISO: U4.C10 (IO_L37N_GCLK12_0); also elsewhere on the board
MOSI: U4.D8 (IO_L38P_0); also elsewhere on the board
unnamed: LD11.- (C), R9.1
unnamed: R10.1, U4.C4 (IO_L1P_HSWAPEN_0)
NE: U4.C8 (IO_L38N_VREF_0); also elsewhere on the board
OE: U4.B6 (IO_L4P_0); also elsewhere on the board
OSC_IN: U4.J16 (IO_L43N_GCLK4_M1DQ5_1); also elsewhere on the board
PMOD2-IO1: U4.A8 (IO_L33N_0); also elsewhere on the board
PMOD2-IO2: U4.A9 (IO_L34N_GCLK18_0); also elsewhere on the board
PMOD2-IO3: U4.B8 (IO_L33P_0); also elsewhere on the board
PMOD2-IO4: U4.C9 (IO_L34P_GCLK19_0); also elsewhere on the board
PROGRAM_B: R23.2, U4.T2 (PROGRAM_B_2)
RED0: U4.B10 (IO_L35P_GCLK17_0); also elsewhere on the board
RED1: U4.A10 (IO_L35N_GCLK16_0); also elsewhere on the board
RED2: U4.C11 (IO_L39P_0); also elsewhere on the board
RTS: U4.C15 (IO_L33P_A15_M1A10_1); also elsewhere on the board
RXD: U4.B15 (IO_L29P_A23_M1A13_1); also elsewhere on the board
SCK: U4.D9 (IO_L40N_0); also elsewhere on the board
SD-DET: U4.J14 (IO_L43P_GCLK5_M1DQ4_1); also elsewhere on the board
SD-LED: U4.H13 (IO_L39P_M1A3_1); also elsewhere on the board
SS: U4.F9 (IO_L40P_0); also elsewhere on the board
SW1: U4.G14 (IO_L36P_A9_M1BA0_1); also elsewhere on the board
SW2: U4.G16 (IO_L36N_A8_M1BA1_1); also elsewhere on the board
SW3: U4.F15 (IO_L35P_A11_M1A7_1); also elsewhere on the board
SW4: U4.F16 (IO_L35N_A10_M1A2_1); also elsewhere on the board
SW5: U4.E15 (IO_L34P_A13_M1WE_1); also elsewhere on the board
SW6: U4.E16 (IO_L34N_A12_M1BA2_1); also elsewhere on the board
SW7: U4.D14 (IO_L31P_A19_M1CKE_1); also elsewhere on the board
SW8: U4.D16 (IO_L31N_A18_M1A12_1); also elsewhere on the board
TCK: SV1.3, U4.C14 (TCK); also elsewhere on the board
TDI: SV1.5, U4.C12 (TDI); also elsewhere on the board
TDO: SV1.4, U4.E14 (TDO); also elsewhere on the board
TMS: SV1.6, U4.A15 (TMS); also elsewhere on the board
TXD: U4.B16 (IO_L29N_A22_M1A14_1); also elsewhere on the board
VSYNC: U4.E11 (IO_L64N_SCP4_0); also elsewhere on the board
WE: U4.J1 (IO_L38N_M3DQ3_3); also elsewhere on the board

Notes on the sheet:
Copyright Saanlima Electronics 2015
Saanlima Electronics
