Saanlima/Pepino/Board/eagle/pepino4.brd

## EAGLE design Board/eagle/pepino4.brd (continued)

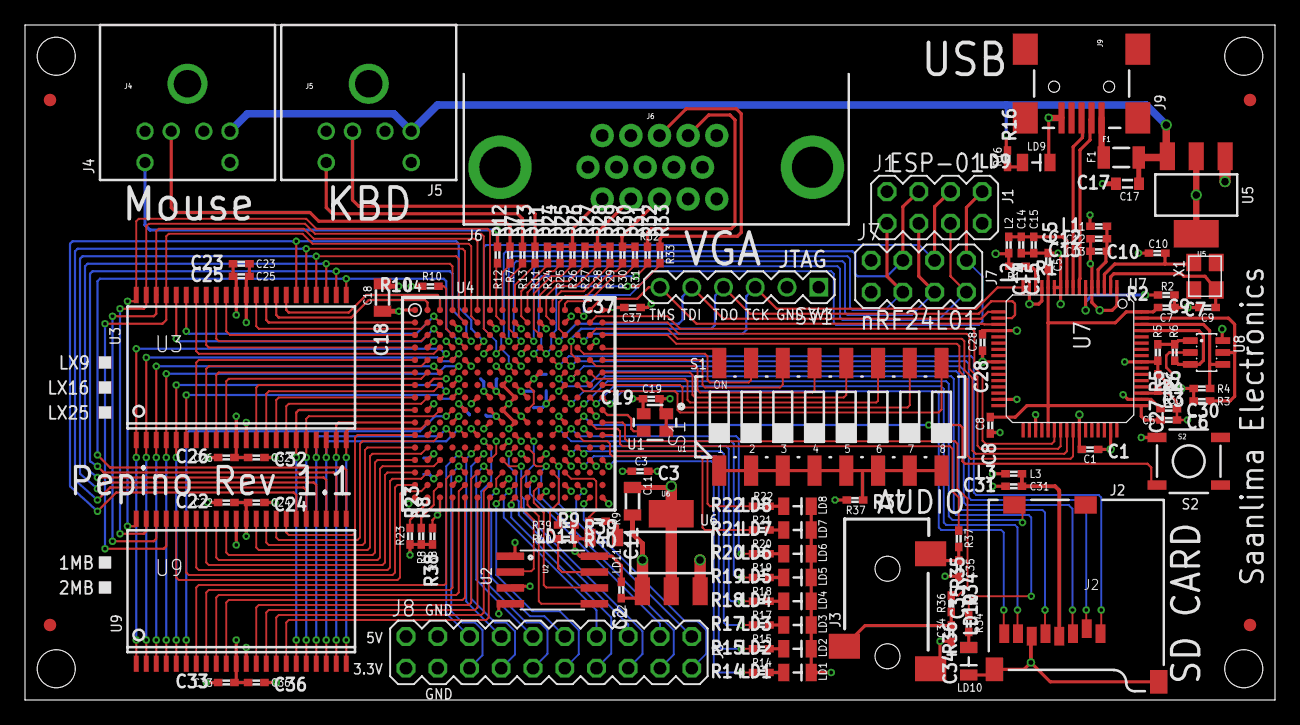
[picture p10: board pepino4.brd from above]

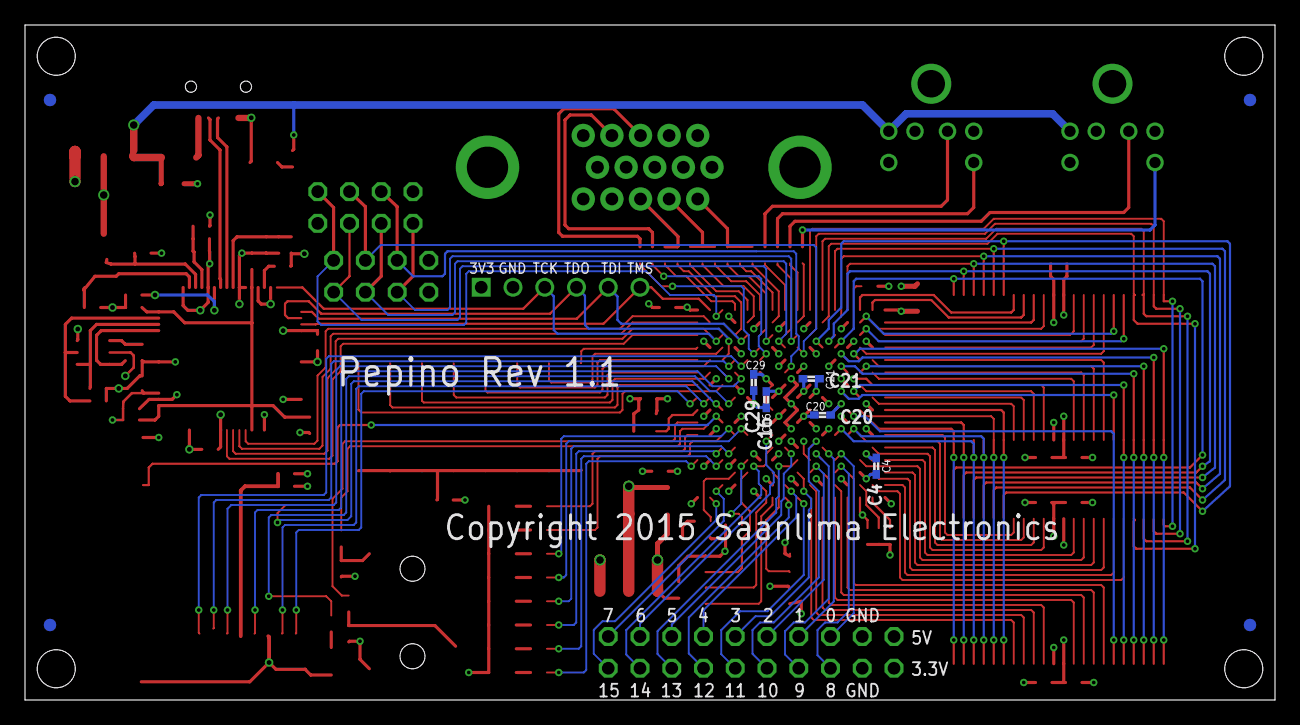
[picture p11: board pepino4.brd from below]

Board: 4 copper layers, 100.0 x 54.0 mm, 122 parts (9 on the bottom side), 183 nets.
