Saanlima/Pepino/Projects/Pepino-pacman/rtl/pacman/pacman.vhd

--
-- A simulation model of Pacman hardware
-- Copyright (c) MikeJ - January 2006
--
-- All rights reserved
--
-- Redistribution and use in source and synthezised forms, with or without
-- modification, are permitted provided that the following conditions are met:
--
-- Redistributions of source code must retain the above copyright notice,
-- this list of conditions and the following disclaimer.
--
-- Redistributions in synthesized form must reproduce the above copyright
-- notice, this list of conditions and the following disclaimer in the
-- documentation and/or other materials provided with the distribution.
--
-- Neither the name of the author nor the names of other contributors may
-- be used to endorse or promote products derived from this software without
-- specific prior written permission.
--
-- THIS CODE IS PROVIDED BY THE COPYRIGHT HOLDERS AND CONTRIBUTORS "AS IS"
-- AND ANY EXPRESS OR IMPLIED WARRANTIES, INCLUDING, BUT NOT LIMITED TO,
-- THE IMPLIED WARRANTIES OF MERCHANTABILITY AND FITNESS FOR A PARTICULAR
-- PURPOSE ARE DISCLAIMED. IN NO EVENT SHALL THE AUTHOR OR CONTRIBUTORS BE
-- LIABLE FOR ANY DIRECT, INDIRECT, INCIDENTAL, SPECIAL, EXEMPLARY, OR
-- CONSEQUENTIAL DAMAGES (INCLUDING, BUT NOT LIMITED TO, PROCUREMENT OF
-- SUBSTITUTE GOODS OR SERVICES; LOSS OF USE, DATA, OR PROFITS; OR BUSINESS
-- INTERRUPTION) HOWEVER CAUSED AND ON ANY THEORY OF LIABILITY, WHETHER IN
-- CONTRACT, STRICT LIABILITY, OR TORT (INCLUDING NEGLIGENCE OR OTHERWISE)
-- ARISING IN ANY WAY OUT OF THE USE OF THIS SOFTWARE, EVEN IF ADVISED OF THE
-- POSSIBILITY OF SUCH DAMAGE.
--
-- You are responsible for any legal issues arising from your use of this code.
--
-- The latest version of this file can be found at: www.fpgaarcade.com
--
-- Email pacman@fpgaarcade.com
--
-- Revision list
--
-- version 005 Papilio release by Jack Gassett
-- version 004 spartan3e release
-- version 003 Jan 2006 release, general tidy up
-- version 002 optional vga scan doubler
-- version 001 initial release
--
library ieee;
  use ieee.std_logic_1164.all;
  use ieee.std_logic_unsigned.all;
  use ieee.numeric_std.all;

library UNISIM;
  use UNISIM.Vcomponents.all;

use work.pkg_pacman.all;
entity PACMAN is
  port (
    O_VIDEO_R             : out   std_logic_vector(3 downto 0);
    O_VIDEO_G             : out   std_logic_vector(3 downto 0);
    O_VIDEO_B             : out   std_logic_vector(3 downto 0);
    O_HSYNC               : out   std_logic;
    O_VSYNC               : out   std_logic;
    O_BLANKING            : out   std_logic_vector(0 downto 0);
    --
    O_AUDIO_L             : out   std_logic;
    O_AUDIO_R             : out   std_logic;
    --
    I_JOYSTICK_A          : in    std_logic_vector(4 downto 0);
    I_JOYSTICK_B          : in    std_logic_vector(4 downto 0);
    JOYSTICK_A_GND			  : out	 std_logic;
    JOYSTICK_B_GND			  : out	 std_logic;
	 
    I_SW                  : in    std_logic_vector(3 downto 0); -- active high
    O_LED                 : out   std_logic_vector(2 downto 0);
    --
    I_RESET               : in    std_logic;
    I_CLK_REF             : in    std_logic;
    I_CLK                 : in    std_logic;
    I_ENA_12              : in    std_logic;
    I_ENA_6               : in    std_logic
    );
end;

architecture RTL of PACMAN is

    signal I_RESET_L        : std_logic;
    signal reset            : std_logic;
    signal clk_ref          : std_logic;
    signal clk              : std_logic;
    signal ena_12           : std_logic;
    signal ena_6            : std_logic;

    -- timing
    signal hcnt             : std_logic_vector(8 downto 0) := "010000000"; -- 80
    signal vcnt             : std_logic_vector(8 downto 0) := "011111000"; -- 0F8

    signal do_hsync         : boolean;
    signal hsync            : std_logic;
    signal vsync            : std_logic;
    signal hblank           : std_logic;
    signal vblank           : std_logic := '1';
    signal h1_inv           : std_logic;
    signal comp_sync_l      : std_logic;

    -- cpu
    signal cpu_ena          : std_logic;
    signal cpu_m1_l         : std_logic;
    signal cpu_mreq_l       : std_logic;
    signal cpu_iorq_l       : std_logic;
    signal cpu_rd_l         : std_logic;
    signal cpu_wr_l         : std_logic;
    signal cpu_rfsh_l       : std_logic;
    signal cpu_halt_l       : std_logic;
    signal cpu_wait_l       : std_logic;
    signal cpu_int_l        : std_logic;
    signal cpu_nmi_l        : std_logic;
    signal cpu_busrq_l      : std_logic;
    signal cpu_busak_l      : std_logic;
    signal cpu_addr         : std_logic_vector(15 downto 0);
    signal cpu_data_out     : std_logic_vector(7 downto 0);
    signal cpu_data_in      : std_logic_vector(7 downto 0);

    signal program_rom_dinl : std_logic_vector(7 downto 0);
    signal program_rom_dinh : std_logic_vector(7 downto 0);
--    signal program_rom_cs_l : std_logic;
    signal sync_bus_cs_l    : std_logic;

    signal control_reg      : std_logic_vector(7 downto 0);
    --
    signal vram_addr_ab     : std_logic_vector(11 downto 0);
    signal ab               : std_logic_vector(11 downto 0);

    signal sync_bus_db      : std_logic_vector(7 downto 0);
    signal sync_bus_r_w_l   : std_logic;
    signal sync_bus_wreq_l  : std_logic;
    signal sync_bus_stb     : std_logic;

    signal cpu_vec_reg      : std_logic_vector(7 downto 0);
    signal sync_bus_reg     : std_logic_vector(7 downto 0);

    signal vram_l           : std_logic;
    signal rams_data_out    : std_logic_vector(7 downto 0);
    -- more decode
    signal wr0_l            : std_logic;
    signal wr1_l            : std_logic;
    signal wr2_l            : std_logic;
    signal iodec_out_l      : std_logic;
    signal iodec_wdr_l      : std_logic;
    signal iodec_in0_l      : std_logic;
    signal iodec_in1_l      : std_logic;
    signal iodec_dipsw_l    : std_logic;

    -- watchdog
    signal watchdog_cnt     : std_logic_vector(3 downto 0);
    signal watchdog_reset_l : std_logic;
    signal freeze           : std_logic;

    -- ip registers
    signal button_in        : std_logic_vector(8 downto 0);
    signal button_debounced : std_logic_vector(8 downto 0);
    signal in0_reg          : std_logic_vector(7 downto 0);
    signal in1_reg          : std_logic_vector(7 downto 0);
    signal dipsw_reg        : std_logic_vector(7 downto 0);
    signal joystick_reg     : std_logic_vector(4 downto 0);

    -- scan doubler signals
    signal video_r          : std_logic_vector(2 downto 0);
    signal video_g          : std_logic_vector(2 downto 0);
    signal video_b          : std_logic_vector(1 downto 0);
    signal blanking         : std_logic_vector(0 downto 0);
    --
    signal video_r_x2       : std_logic_vector(2 downto 0);
    signal video_g_x2       : std_logic_vector(2 downto 0);
    signal video_b_x2       : std_logic_vector(1 downto 0);
    signal hsync_x2         : std_logic;
    signal vsync_x2         : std_logic;
    signal blanking_x2      : std_logic_vector(0 downto 0);
    --
    signal audio            : std_logic_vector(7 downto 0);
    signal audio_pwm        : std_logic;
	 
    signal scan_converter_mode        : std_logic;


begin
  I_RESET_L <= not I_RESET;
  
  ena_12 <= I_ENA_12;
  ena_6 <= I_ENA_6;
  clk <= I_CLK;
  clk_ref <= I_CLK_REF;
  
  joystick_reg <= I_JOYSTICK_A and I_JOYSTICK_B;
  JOYSTICK_A_GND <= '0';
  JOYSTICK_B_GND <= '0';
  
  --
  -- video timing
  --
  p_hvcnt : process
    variable hcarry,vcarry : boolean;
  begin
    wait until rising_edge(clk);
    if (ena_6 = '1') then
      hcarry := (hcnt = "111111111");
      if hcarry then
        hcnt <= "010000000"; -- 080
--        hcnt <= "001110110"; -- 076
      else
        hcnt <= hcnt +"1";
      end if;
      -- hcnt 8 on circuit is 256H_L
      vcarry := (vcnt = "111111111");
      if do_hsync then
        if vcarry then
          vcnt <= "011111000"; -- 0F8
        else
          vcnt <= vcnt +"1";
        end if;
      end if;
    end if;
  end process;

  p_sync_comb : process(hcnt, vcnt)
  begin
    vsync <= not vcnt(8);
    do_hsync <= (hcnt = "010101111"); -- 0AF
  end process;

  p_sync : process
  begin
    wait until rising_edge(clk);
    if (ena_6 = '1') then
      -- Timing hardware is coded differently to the real hw
      -- to avoid the use of multiple clocks. Result is identical.

      if (hcnt = "010001111") then -- 08F
        hblank <= '1';
      elsif (hcnt = "011101111") then
        hblank <= '0'; -- 0EF
      end if;

      if do_hsync then
        hsync <= '1';
      elsif (hcnt = "011001111") then -- 0CF
        hsync <= '0';
      end if;

      if do_hsync then
        if (vcnt = "111101111") then -- 1EF
          vblank <= '1';
        elsif (vcnt = "100001111") then -- 10F
          vblank <= '0';
        end if;
      end if;
    end if;
  end process;

  p_comp_sync : process(hsync, vsync)
  begin
    comp_sync_l <= (not vsync) and (not hsync);
  end process;
  --
  -- cpu
  --
  p_cpu_wait_comb : process(freeze, sync_bus_wreq_l)
  begin
    cpu_wait_l  <= '1';
    if (freeze = '1') or (sync_bus_wreq_l = '0') then
      cpu_wait_l  <= '0';
    end if;
  end process;

  p_irq_req_watchdog : process
    variable rising_vblank : boolean;
  begin
    wait until rising_edge(clk);
    if (ena_6 = '1') then
      rising_vblank := do_hsync and (vcnt = "111101111"); -- 1EF
      --rising_vblank := do_hsync; -- debug
      -- interrupt 8c

      if (control_reg(0) = '0') then
        cpu_int_l <= '1';
      elsif rising_vblank then -- 1EF
        cpu_int_l <= '0';
      end if;

      -- watchdog 8c
      -- note sync reset
      if (reset = '1') then
        watchdog_cnt <= "1111";
      elsif (iodec_wdr_l = '0') then
        watchdog_cnt <= "0000";
      elsif rising_vblank and (freeze = '0') then
        watchdog_cnt <= watchdog_cnt + "1";
      end if;


      watchdog_reset_l <= '1';
      if (watchdog_cnt = "1111") then
        watchdog_reset_l <= '0';
      end if;

      -- simulation
      -- pragma translate_off
      -- synopsys translate_off
      watchdog_reset_l <= not reset; -- watchdog disable
      -- synopsys translate_on
      -- pragma translate_on
    end if;
  end process;

  -- other cpu signals
  cpu_busrq_l <= '1';
  cpu_nmi_l   <= '1';
  h1_inv <= not hcnt(0);

  p_cpu_ena : process(hcnt, ena_6)
  begin
    cpu_ena <= '0';
    if (ena_6 = '1') then
      cpu_ena <= hcnt(0);
    end if;
  end process;

  u_cpu : entity work.T80sed
          port map (
              RESET_n => watchdog_reset_l,
              CLK_n   => clk,
              CLKEN   => cpu_ena,
              WAIT_n  => cpu_wait_l,
              INT_n   => cpu_int_l,
              NMI_n   => cpu_nmi_l,
              BUSRQ_n => cpu_busrq_l,
              M1_n    => cpu_m1_l,
              MREQ_n  => cpu_mreq_l,
              IORQ_n  => cpu_iorq_l,
              RD_n    => cpu_rd_l,
              WR_n    => cpu_wr_l,
              RFSH_n  => cpu_rfsh_l,
              HALT_n  => cpu_halt_l,
              BUSAK_n => cpu_busak_l,
              A       => cpu_addr,
              DI      => cpu_data_in,
              DO      => cpu_data_out
              );
  --
  -- primary addr decode
  --
  p_mem_decode_comb : process(cpu_rfsh_l, cpu_rd_l, cpu_mreq_l, cpu_addr)
  begin
    -- rom     0x0000 - 0x3FFF
    -- syncbus 0x4000 - 0x7FFF

    -- 7M
    -- 7N
    sync_bus_cs_l <= '1';
--    program_rom_cs_l  <= '1';

    if (cpu_mreq_l = '0') and (cpu_rfsh_l = '1') then

--      if (cpu_addr(14) = '0') and (cpu_rd_l = '0') then
--         program_rom_cs_l <= '0';
--      end if;

      if (cpu_addr(14) = '1') then
         sync_bus_cs_l <= '0';
      end if;

    end if;
  end process;
  --
  -- sync bus custom ic
  --
  p_sync_bus_reg : process
  begin
    wait until rising_edge(clk);
    if (ena_6 = '1') then
      -- register on sync bus module that is used to store interrupt vector
      if (cpu_iorq_l = '0') and (cpu_m1_l = '1') then
        cpu_vec_reg <= cpu_data_out;
      end if;

      -- read holding reg
      if (hcnt(1 downto 0) = "01") then
        sync_bus_reg <= cpu_data_in;
      end if;
    end if;
  end process;

  p_sync_bus_comb : process(cpu_rd_l, sync_bus_cs_l, hcnt)
  begin
    -- sync_bus_stb is now an active low clock enable signal
    sync_bus_stb <= '1';
    sync_bus_r_w_l <= '1';

    if (sync_bus_cs_l = '0') and (hcnt(1) = '0') then
      if (cpu_rd_l = '1') then
        sync_bus_r_w_l <= '0';
      end if;
      sync_bus_stb <= '0';
    end if;

    sync_bus_wreq_l <= '1';
    if (sync_bus_cs_l = '0') and (hcnt(1) = '1') and (cpu_rd_l = '0') then
      sync_bus_wreq_l <= '0';
    end if;
  end process;
  --
  -- vram addr custom ic
  --
  u_vram_addr : entity work.PACMAN_VRAM_ADDR
    port map (
      AB      => vram_addr_ab,
      H256_L  => hcnt(8),
      H128    => hcnt(7),
      H64     => hcnt(6),
      H32     => hcnt(5),
      H16     => hcnt(4),
      H8      => hcnt(3),
      H4      => hcnt(2),
      H2      => hcnt(1),
      H1      => hcnt(0),
      V128    => vcnt(7),
      V64     => vcnt(6),
      V32     => vcnt(5),
      V16     => vcnt(4),
      V8      => vcnt(3),
      V4      => vcnt(2),
      V2      => vcnt(1),
      V1      => vcnt(0),
      FLIP    => control_reg(3)
      );

  p_ab_mux_comb : process(hcnt, cpu_addr, vram_addr_ab)
  begin
    --When 2H is low, the CPU controls the bus.
    if (hcnt(1) = '0') then
      ab <= cpu_addr(11 downto 0);
    else
      ab <= vram_addr_ab;
    end if;
  end process;

  p_vram_comb : process(hcnt, cpu_addr, sync_bus_stb)
    variable a,b : std_logic;
  begin

    a := not (cpu_addr(12) or sync_bus_stb);
    b := hcnt(1) and hcnt(0);
    vram_l <= not (a or b);
  end process;

  p_io_decode_comb : process(sync_bus_r_w_l, sync_bus_stb, ab, cpu_addr)
    variable sel  : std_logic_vector(2 downto 0);
    variable dec  : std_logic_vector(7 downto 0);
    variable selb : std_logic_vector(1 downto 0);
    variable decb : std_logic_vector(3 downto 0);
  begin
    -- WRITE

    -- out_l 0x5000 - 0x503F control space

    -- wr0_l 0x5040 - 0x504F sound
    -- wr1_l 0x5050 - 0x505F sound
    -- wr2_l 0x5060 - 0x506F sprite

    --       0x5080 - 0x50BF unused

    -- wdr_l 0x50C0 - 0x50FF watchdog reset

    -- READ

    -- in0_l   0x5000 - 0x503F in port 0
    -- in1_l   0x5040 - 0x507F in port 1
    -- dipsw_l 0x5080 - 0x50BF dip switches

    -- 7J
    dec := "11111111";
    sel := sync_bus_r_w_l & ab(7) & ab(6);
    if (cpu_addr(12) = '1') and ( sync_bus_stb = '0')  then
      case sel is
        when "000" => dec := "11111110";
        when "001" => dec := "11111101";
        when "010" => dec := "11111011";
        when "011" => dec := "11110111";
        when "100" => dec := "11101111";
        when "101" => dec := "11011111";
        when "110" => dec := "10111111";
        when "111" => dec := "01111111";
        when others => null;
      end case;
    end if;
    iodec_out_l   <= dec(0);
    iodec_wdr_l   <= dec(3);

    iodec_in0_l   <= dec(4);
    iodec_in1_l   <= dec(5);
    iodec_dipsw_l <= dec(6);

    -- 7M
    decb := "1111";
    selb := ab(5) & ab(4);
    if (dec(1) = '0') then
      case selb is
        when "00" => decb := "1110";
        when "01" => decb := "1101";
        when "10" => decb := "1011";
        when "11" => decb := "0111";
        when others => null;
      end case;
    end if;
    wr0_l <= decb(0);
    wr1_l <= decb(1);
    wr2_l <= decb(2);

  end process;


	O_LED(0) <= control_reg(4);	-- P1 Start Lamp
	O_LED(1) <= control_reg(5);	-- P2 Start Lamp	
	O_LED(2) <= control_reg(3);	-- Flipped

  p_control_reg : process
    variable ena : std_logic_vector(7 downto 0);
  begin
    -- 8 bit addressable latch 7K
    -- (made into register)

    -- 0 interrupt ena
    -- 1 sound ena
    -- 2 not used
    -- 3 flip
    -- 4 1 player start lamp
    -- 5 2 player start lamp
    -- 6 coin lockout
    -- 7 coin counter

    wait until rising_edge(clk);
    if (ena_6 = '1') then
      ena := "00000000";
      if (iodec_out_l = '0') then
        case ab(2 downto 0) is
          when "000" => ena := "00000001";
          when "001" => ena := "00000010";
          when "010" => ena := "00000100";
          when "011" => ena := "00001000";
          when "100" => ena := "00010000";
          when "101" => ena := "00100000";
          when "110" => ena := "01000000";
          when "111" => ena := "10000000";
          when others => null;
        end case;
      end if;

      if (watchdog_reset_l = '0') then
        control_reg <= (others => '0');
      else
        for i in 0 to 7 loop
          if (ena(i) = '1') then
            control_reg(i) <= cpu_data_out(0);
          end if;
        end loop;
      end if;
    end if; 
  end process;

  p_db_mux_comb : process(hcnt, cpu_data_out, rams_data_out)
  begin
    -- simplified data source for video subsystem
    -- only cpu or ram are sources of interest
    if (hcnt(1) = '0') then
      sync_bus_db <= cpu_data_out;
    else
      sync_bus_db <= rams_data_out;
    end if;
  end process;

  p_cpu_data_in_mux_comb : process(cpu_addr, cpu_iorq_l, cpu_m1_l, sync_bus_wreq_l,
                                   iodec_in0_l, iodec_in1_l, iodec_dipsw_l)
  begin
    -- simplifed again
    if (cpu_iorq_l = '0') and (cpu_m1_l = '0') then
      cpu_data_in <= cpu_vec_reg;
    elsif (sync_bus_wreq_l = '0') then
      cpu_data_in <= sync_bus_reg;
    else
      if (cpu_addr(15 downto 14) = "00") then      -- ROM at 0000 - 3fff
        cpu_data_in <= program_rom_dinl;
      elsif (cpu_addr(15 downto 13) = "100") then  -- ROM at 8000 - 9fff
        cpu_data_in <= program_rom_dinh;
      else
        cpu_data_in <= rams_data_out;
        if (iodec_in0_l   = '0') then cpu_data_in <= in0_reg; end if;
        if (iodec_in1_l   = '0') then cpu_data_in <= in1_reg; end if;
        if (iodec_dipsw_l = '0') then cpu_data_in <= dipsw_reg; end if;
      end if;
    end if;
  end process;

  u_rams : entity work.PACMAN_RAMS
    port map (
      -- note, we get a one clock delay from our rams
      I_AB     => ab,
      I_DATA   => cpu_data_out, -- cpu only source of ram data
      O_DATA   => rams_data_out,
      I_R_W_L  => sync_bus_r_w_l,
      I_VRAM_L => vram_l,
      ENA_6    => ena_6,
      CLK      => clk
      );

  -- example of internal program rom, if you have a big enough device
  u_program_rom : entity work.ROM_PGM_0
    port map (
      CLK         => clk,
      ENA         => ena_6,
      ADDR        => cpu_addr(13 downto 0),
      DATA        => program_rom_dinl
      );

--	Commented out for use on the Papilio board so ROMs can be merged into the bitstream. Not enough BRAM to include this for the Papilio One.
--  u_program_wiz : entity work.ROM_PGM_1
--    port map (
--      CLK         => clk,
--      ENA         => ena_6,
--      ADDR        => cpu_addr(12 downto 0),
--      DATA        => program_rom_dinh
--      );

  --
  -- video subsystem
  --
  u_video : entity work.PACMAN_VIDEO
    port map (
      I_HCNT        => hcnt,
      I_VCNT        => vcnt,
      --
      I_AB          => ab,
      I_DB          => sync_bus_db,
      --
      I_HBLANK      => hblank,
      I_VBLANK      => vblank,
      I_FLIP        => control_reg(3),
      I_WR2_L       => wr2_l,
      --
      O_RED         => video_r,
      O_GREEN       => video_g,
      O_BLUE        => video_b,
      O_BLANKING    => blanking,
      --
      ENA_6         => ena_6,
      CLK           => clk
      );

  -- if PACMAN_DBLSCAN used, remember to add pacman_dblscan.vhd to the
  -- sythesis script you are using (pacman.prg for xst / webpack)
  --
  u_dblscan : entity work.VGA_SCANDBL
    port map (
      I_R          => video_r,
      I_G          => video_g,
      I_B          => video_b,
      I_HSYNC      => hsync,
      I_VSYNC      => vsync,
      I_BLANKING   => blanking,

      O_R          => video_r_x2,
      O_G          => video_g_x2,
      O_B          => video_b_x2,
      O_HSYNC      => hsync_x2,
      O_VSYNC      => vsync_x2,
      O_BLANKING   => blanking_x2,
      --
      CLK          => ena_6,
      CLK_X2       => ena_12
    );

	scan_converter_mode <= '1';
  p_video_ouput : process
  begin
    wait until rising_edge(clk);
    -- switch is on (up) use scan converter and light led
--    O_LED(3 downto 1) <= "000";

    O_VIDEO_R(0) <= '0';
    O_VIDEO_G(0) <= '0';
    O_VIDEO_B(1 downto 0) <= "00";

    if (scan_converter_mode = '1') then
--      O_LED(0) <= '1';
      O_VIDEO_R(3 downto 1) <= video_r_x2;
      O_VIDEO_G(3 downto 1) <= video_g_x2;
      O_VIDEO_B(3 downto 2) <= video_b_x2;
      O_HSYNC   <= hSync_X2;
      O_VSYNC   <= vSync_X2;
      O_BLANKING <= blanking_x2;
    else
--      O_LED(0) <= '0';
      O_VIDEO_R(3 downto 1) <= video_r;
      O_VIDEO_G(3 downto 1) <= video_g;
      O_VIDEO_B(3 downto 2) <= video_b;
      O_HSYNC   <= hSync;
      O_VSYNC   <= vSync;
      O_BLANKING <= blanking;
    end if;
  end process;
  --O_COMP_SYNC_L <= comp_sync_l;

  --
  --
  -- audio subsystem
  --
  u_audio : entity work.PACMAN_AUDIO
    port map (
      I_HCNT        => hcnt,
      --
      I_AB          => ab,
      I_DB          => sync_bus_db,
      --
      I_WR1_L       => wr1_l,
      I_WR0_L       => wr0_l,
      I_SOUND_ON    => control_reg(1),
      --
      O_AUDIO       => audio,
      ENA_6         => ena_6,
      CLK           => clk
      );
  --
  -- Audio DAC
  --
  u_dac : entity work.dac
    generic map(
      msbi_g => 7
    )
    port  map(
      clk_i   => clk_ref,
      res_n_i => I_RESET_L,
      dac_i   => audio,
      dac_o   => audio_pwm
    );

  O_AUDIO_L <= audio_pwm;
  O_AUDIO_R <= audio_pwm;

  button_in(8 downto 5) <= I_SW(3 downto 0);
  button_in(4 downto 0) <= joystick_reg(4 downto 0);

  u_debounce : entity work.PACMAN_DEBOUNCE
  generic map (
    G_WIDTH => 9
    )
  port map (
    I_BUTTON => button_in,
    O_BUTTON => button_debounced,
    CLK      => clk
    );

--button_debounced	Arcade MegaWing Location
--			8						RIGHT PushButton
--			7						DOWN PushButton
--			6						UP PushButton
--			5						LEFT PushButton
--			4						Fire Joystick
--			3						RIGHT Joystick
--			2						LEFT Joystick
--			1						DOWN Joystick
--			0						UP Joystick

  p_input_registers : process
  begin
    wait until rising_edge(clk);
    if (ena_6 = '1') then
		-- on is low
      in0_reg(7) <= not button_debounced(6); -- credit	Up Pushbutton
      in0_reg(6) <= '1';							-- coin2    
      in0_reg(5) <= not button_debounced(7); -- coin1		DOWN PushButton
      in0_reg(4) <= '1'; 							-- test_l dipswitch (rack advance)
      in0_reg(3) <= button_debounced(1); 		-- p1 down
      in0_reg(2) <= button_debounced(3); 		-- p1 right
      in0_reg(1) <= button_debounced(2); 		-- p1 left
      in0_reg(0) <= button_debounced(0); 		-- p1 up

      in1_reg(7) <= '0'; 							-- table
      in1_reg(6) <= not button_debounced(8); -- start2		RIGHT PushButton
      in1_reg(5) <= not button_debounced(5); -- start1		LEFT PushButton
      in1_reg(4) <= button_debounced(4);		-- test and fire	
      in1_reg(3) <= button_debounced(1);		-- p2 down
      in1_reg(2) <= button_debounced(3); 		-- p2 right
      in1_reg(1) <= button_debounced(2); 		-- p2 left
      in1_reg(0) <= button_debounced(0); 		-- p2 up		

      -- on is low
      freeze <= '0';
      dipsw_reg(7) <= '1'; -- character set ?
      dipsw_reg(6) <= '1'; -- difficulty ?
      dipsw_reg(5 downto 4) <= "00"; -- bonus pacman at 10K
      dipsw_reg(3 downto 2) <= "10"; -- pacman (3)
      dipsw_reg(1 downto 0) <= "01"; -- cost  (1 coin, 1 play)
    end if;
  end process;

end RTL;
