Saanlima/Pepino/Projects/OLS_SRAM_edgetriggers_buffer/verilog/async_fifo.v

//--------------------------------------------------------------------------------
//
// async_fifo.v
// Copyright (C) 2011 Ian Davis
// 
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
//--------------------------------------------------------------------------------
//
// Details: 
//   http://www.dangerousprototypes.com/ols
//   http://www.gadgetfactory.net/gf/project/butterflylogic
//   http://www.mygizmos.org/ols
// 
// An asynchronous FIFO.  Defaults to (16 words)x(32 bit)
//
// Accepts data written in one clock domain, writes the data to a FIFO ram,
// safely transfers the fifo write/read pointers using gray encoded counters,
// and reads the data (in the second clock domain).
//
// No timing hazards, or chance of skewing input data words because individual
// bits "arrived" out of phase.
//
// In detail, the steps are:
//  1) Write data to a dual-port RAM in the source clock domain.   
//  2) Update fifo write pointer.
//  3) Synchronize a gray-encoded version of the write pointer in the 
//       destination clock domain.   
//  4) Read data from the dual-port RAM in the destiantion clock.
//  5) Update the read pointer.
//  6) Synchronize a gray-encoded version of the read pointer back 
//       to the source clock domain.   
//  7) The loop is now closed
//
// Note the write clock always has a laggy version of the read pointer.
// Guarantees it can't overflow (assuming the writer cares).
//
// The read clock always has a laggy version of the write pointer.
// Guarantees data present before reading occurs.
//
//--------------------------------------------------------------------------------
//
// Notes on Synchronizers...
//
// Synchronizing simply means using two or more back-to-back flops to 
// move a signal from one clock domain to another.
//
// Why at least two?   Because theoretically a flop can become metastable 
// (not in 0 or 1 state) if its data input twitches at just the wrong moment
// too close to the clock.  A worst-case setup//hold timing violation.
//
// A flop eventually recovers, but the speed at which it does so depends 
// in large part on its output capacitive load.  A second flop minmizes the
// load & gives a near 100% chance (99.99999%) of capturing stable data.
// For very sensitive applications, you increase the number of flops, or use
// more conservative synchronization techniques.
//
//--------------------------------------------------------------------------------
//
module async_fifo (
  wrclk, wrreset, rdclk, rdreset,
  // write path
  space_avail, wrenb, wrdata,
  // read path
  read_req, data_avail, 
  data_valid, data_out);

parameter ASYNC_FIFO_MAXINDEX = 3;
parameter ASYNC_FIFO_MAXDATA = 31;
parameter ASYNC_FIFO_FULLTHRESHOLD = 4;		// full when only 4 words remain

input wrclk, wrreset;
input rdclk, rdreset;

// Write path...
output space_avail;
input wrenb;
input [ASYNC_FIFO_MAXDATA:0] wrdata;

// Read path...
input read_req;
output data_avail, data_valid;
output [ASYNC_FIFO_MAXDATA:0] data_out;

wire [ASYNC_FIFO_MAXINDEX+1:0] stable_wrptr, stable_rdptr;
wire [ASYNC_FIFO_MAXINDEX:0] ram_wraddr, ram_rdaddr;
wire [ASYNC_FIFO_MAXDATA:0] ram_wrdata, ram_rddata;

//
// Instantiate RAM...
//
async_fifo_ram ram (
  wrclk, rdclk, 
  ram_wrenb, ram_wraddr, ram_wrdata, 
  ram_rdenb, ram_rdaddr, ram_rddata);

defparam ram.ASYNC_FIFO_MAXINDEX = ASYNC_FIFO_MAXINDEX;
defparam ram.ASYNC_FIFO_MAXDATA = ASYNC_FIFO_MAXDATA;


//
// Instantiate write path...
//
async_fifo_wrpath wrpath (
  wrclk, wrreset, 
  space_avail, wrenb, wrdata,
  ram_wrenb, ram_wraddr, ram_wrdata,
  stable_wrptr, stable_rdptr);

defparam wrpath.ASYNC_FIFO_MAXINDEX = ASYNC_FIFO_MAXINDEX;
defparam wrpath.ASYNC_FIFO_MAXDATA = ASYNC_FIFO_MAXDATA;
defparam wrpath.ASYNC_FIFO_FULLTHRESHOLD = ASYNC_FIFO_FULLTHRESHOLD;


//
// Instantiate read path...
//
async_fifo_rdpath rdpath (
  rdclk, rdreset, 
  read_req, data_avail, 
  data_valid, data_out,
  ram_rdenb, ram_rdaddr, ram_rddata,
  stable_wrptr, stable_rdptr);

defparam rdpath.ASYNC_FIFO_MAXINDEX = ASYNC_FIFO_MAXINDEX;
defparam rdpath.ASYNC_FIFO_MAXDATA = ASYNC_FIFO_MAXDATA;

endmodule



///////////////////////////////////////////////////////////
//
//  Generic ASYNC fifo.  Write path...
//
module async_fifo_wrpath (
  clk, reset, 
  space_avail, data_valid, wrdata,
  ram_wrenb, ram_wraddr, ram_wrdata,
  stable_wrptr, stable_rdptr);

parameter ASYNC_FIFO_MAXINDEX = 3;
parameter ASYNC_FIFO_MAXDATA = 31;
parameter ASYNC_FIFO_FULLTHRESHOLD = 4;

input clk, reset;

// FIFO interface...
output space_avail;
input data_valid;
input [ASYNC_FIFO_MAXDATA:0] wrdata;

// RAM interface...
output ram_wrenb;
output [ASYNC_FIFO_MAXINDEX:0] ram_wraddr;
output [ASYNC_FIFO_MAXDATA:0] ram_wrdata;

// Sync interface...
output [ASYNC_FIFO_MAXINDEX+1:0] stable_wrptr;
input [ASYNC_FIFO_MAXINDEX+1:0] stable_rdptr;

localparam WIDTH = ASYNC_FIFO_MAXINDEX+2;
`include "gray.v"


//
// Registers...
//
reg [ASYNC_FIFO_MAXINDEX+1:0] stable_wrptr, next_stable_wrptr;
reg [ASYNC_FIFO_MAXINDEX+1:0] wrptr, next_wrptr;
reg [ASYNC_FIFO_MAXINDEX+1:0] rdptr, next_rdptr;
reg space_avail, next_space_avail;

wire [ASYNC_FIFO_MAXINDEX+1:0] wrptr_plus1 = wrptr+1'b1;
wire [ASYNC_FIFO_MAXINDEX+1:0] fifo_depth = wrptr-rdptr;

wire [ASYNC_FIFO_MAXINDEX+1:0] gray_rdptr;
full_synchronizer #(WIDTH) sync_gray_rdptr (clk, reset, stable_rdptr, gray_rdptr);


//
// RAM interface...
//
wire ram_wrenb = data_valid;
wire [ASYNC_FIFO_MAXINDEX:0] ram_wraddr = wrptr[ASYNC_FIFO_MAXINDEX:0];
wire [ASYNC_FIFO_MAXDATA:0] ram_wrdata = wrdata;


//
// Sample stable singals...
//
initial 
begin 
  stable_wrptr = 0;
  rdptr = 0;
end
always @ (posedge clk or posedge reset)
begin
  if (reset) 
    begin
      stable_wrptr = 0;
      rdptr = 0;
    end
  else
    begin
      stable_wrptr = next_stable_wrptr;
      rdptr = next_rdptr;
    end
end

always @(*)
begin
  #1;
  next_stable_wrptr = bin2gray(next_wrptr);
  next_rdptr = gray2bin(gray_rdptr);
end


//
// Control logic...
//
initial 
begin 
  space_avail = 0;
  wrptr = 0;
end
always @ (posedge clk or posedge reset)
begin
  if (reset) 
    begin
      space_avail = 1'b1;
      wrptr = 0;
    end
  else
    begin
      space_avail = next_space_avail;
      wrptr = next_wrptr;
      // synthesis translate_off
      if (data_valid)
	begin
          #1; 
	  if (fifo_depth >= (1<<(ASYNC_FIFO_MAXINDEX+1)))
            begin
              $display ("%t: FIFO OVERFLOW!",$realtime);
              $finish;
            end
	end
      // synthesis translate_on
    end
end

always @(*)
begin
  #1;
  next_space_avail = fifo_depth<((1<<(ASYNC_FIFO_MAXINDEX+1))-ASYNC_FIFO_FULLTHRESHOLD);
  next_wrptr = (data_valid && space_avail) ? wrptr_plus1 : wrptr;
end
endmodule




///////////////////////////////////////////////////////////
//
//  Read path...
//
module async_fifo_rdpath (
  clk, reset, 
  read_req, data_avail, 
  data_valid, data_out,
  ram_rdenb, ram_rdaddr, ram_rddata,
  stable_wrptr, stable_rdptr);

parameter ASYNC_FIFO_MAXINDEX = 3;
parameter ASYNC_FIFO_MAXDATA = 31;

input clk, reset;

// FIFO interface...
input read_req;
output data_avail, data_valid;
output [ASYNC_FIFO_MAXDATA:0] data_out;

// RAM interface...
output ram_rdenb;
output [ASYNC_FIFO_MAXINDEX:0] ram_rdaddr;
input [ASYNC_FIFO_MAXDATA:0] ram_rddata;

// Sync interface...
input [ASYNC_FIFO_MAXINDEX+1:0] stable_wrptr;
output [ASYNC_FIFO_MAXINDEX+1:0] stable_rdptr;

localparam WIDTH = ASYNC_FIFO_MAXINDEX+2;
`include "gray.v"


//
// Registers...
//
reg [ASYNC_FIFO_MAXINDEX+1:0] stable_rdptr, next_stable_rdptr;
reg [ASYNC_FIFO_MAXINDEX+1:0] wrptr, next_wrptr;

reg data_avail, next_data_avail;
reg data_valid, next_data_valid;
reg [ASYNC_FIFO_MAXINDEX+1:0] rdptr, next_rdptr;
reg [ASYNC_FIFO_MAXDATA:0] data_out, next_data_out;

wire ram_rdenb = data_avail;
reg [ASYNC_FIFO_MAXINDEX:0] ram_rdaddr;

wire [ASYNC_FIFO_MAXINDEX+1:0] rdptr_plus1 = rdptr+1'b1;

wire [ASYNC_FIFO_MAXINDEX+1:0] gray_wrptr;
full_synchronizer #(WIDTH) sync_gray_wrptr (clk, reset, stable_wrptr, gray_wrptr);


//
// Sample stable singals...
//
initial
begin
  stable_rdptr = 0;
  wrptr = 0;
end
always @ (posedge clk or posedge reset)
begin
  if (reset)
    begin
      stable_rdptr = 0;
      wrptr = 0;
    end
  else
    begin
      stable_rdptr = next_stable_rdptr;
      wrptr = next_wrptr;
    end
end

always @(*)
begin
  #1;
  next_stable_rdptr = bin2gray(rdptr);
  next_wrptr = gray2bin(gray_wrptr);
end


//
// Control logic...
//
initial 
begin
  rdptr = 0;
  data_avail = 1'b0;
  data_valid = 1'b0;
end
always @ (posedge clk or posedge reset)
begin
  if (reset) 
    begin
      rdptr = 0;
      data_avail = 1'b0;
      data_valid = 1'b0;
    end
  else
    begin
      rdptr = next_rdptr;
      data_avail = next_data_avail;
      data_valid = next_data_valid;
    end
end
always @ (posedge clk) data_out = next_data_out;

always @(*)
begin
  #1;
  next_rdptr = rdptr;
  next_data_out = {(ASYNC_FIFO_MAXDATA+1){data_avail}} & ram_rddata;
  next_data_valid = 1'b0;

  if (read_req && data_avail)
    begin
      next_data_valid = 1'b1;
      next_rdptr = rdptr_plus1;
    end

  next_data_avail = (next_wrptr != next_rdptr);
  ram_rdaddr = next_rdptr[ASYNC_FIFO_MAXINDEX:0];
end
endmodule




///////////////////////////////////////////////////////////
//
//  Async FIFO RAM...
//
module async_fifo_ram (wrclk, rdclk, wrenb, wrptr, wrdata, rdenb, rdptr, rddata);

parameter ASYNC_FIFO_MAXINDEX = 4;
parameter ASYNC_FIFO_MAXDATA = 31;

input wrclk, rdclk;
input wrenb, rdenb;
input [ASYNC_FIFO_MAXINDEX:0] wrptr, rdptr;
input [ASYNC_FIFO_MAXDATA:0] wrdata;
output [ASYNC_FIFO_MAXDATA:0] rddata;

wire #1 dly_wrenb = wrenb;
wire [ASYNC_FIFO_MAXINDEX:0] #1 dly_wrptr = wrptr;
wire [ASYNC_FIFO_MAXDATA:0] #1 dly_wrdata = wrdata;

wire #1 dly_rdenb = rdenb;
wire [ASYNC_FIFO_MAXINDEX:0] #1 dly_rdptr = rdptr;

reg [ASYNC_FIFO_MAXDATA:0] mem[0:(1<<(ASYNC_FIFO_MAXINDEX+1))-1];
reg [ASYNC_FIFO_MAXINDEX:0] rdptr_reg;
assign rddata = mem[rdptr_reg];

always @ (posedge wrclk)
begin
  if (dly_wrenb) mem[dly_wrptr] = dly_wrdata;
end
always @ (posedge rdclk)
begin
  rdptr_reg = dly_rdptr;
end
endmodule
