Saanlima/Pepino/Projects/Pepino-pacman/rtl/pacman/gfx1.vhd

-- generated with romgen v3.0 by MikeJ
library ieee;
  use ieee.std_logic_1164.all;
  use ieee.std_logic_unsigned.all;
  use ieee.numeric_std.all;

library UNISIM;
  use UNISIM.Vcomponents.all;

entity GFX1 is
  port (
    CLK         : in    std_logic;
    ENA         : in    std_logic;
    ADDR        : in    std_logic_vector(12 downto 0);
    DATA        : out   std_logic_vector(7 downto 0)
    );
end;

architecture RTL of GFX1 is

  function romgen_str2bv (str : string) return bit_vector is
    variable result : bit_vector (str'length*4-1 downto 0);
  begin
    for i in 0 to str'length-1 loop
      case str(str'high-i) is
        when '0'       => result(i*4+3 downto i*4) := x"0";
        when '1'       => result(i*4+3 downto i*4) := x"1";
        when '2'       => result(i*4+3 downto i*4) := x"2";
        when '3'       => result(i*4+3 downto i*4) := x"3";
        when '4'       => result(i*4+3 downto i*4) := x"4";
        when '5'       => result(i*4+3 downto i*4) := x"5";
        when '6'       => result(i*4+3 downto i*4) := x"6";
        when '7'       => result(i*4+3 downto i*4) := x"7";
        when '8'       => result(i*4+3 downto i*4) := x"8";
        when '9'       => result(i*4+3 downto i*4) := x"9";
        when 'A'       => result(i*4+3 downto i*4) := x"A";
        when 'B'       => result(i*4+3 downto i*4) := x"B";
        when 'C'       => result(i*4+3 downto i*4) := x"C";
        when 'D'       => result(i*4+3 downto i*4) := x"D";
        when 'E'       => result(i*4+3 downto i*4) := x"E";
        when 'F'       => result(i*4+3 downto i*4) := x"F";
        when others    => null;
      end case;
    end loop;
    return result;
  end romgen_str2bv;

  attribute INIT_00 : string;
  attribute INIT_01 : string;
  attribute INIT_02 : string;
  attribute INIT_03 : string;
  attribute INIT_04 : string;
  attribute INIT_05 : string;
  attribute INIT_06 : string;
  attribute INIT_07 : string;
  attribute INIT_08 : string;
  attribute INIT_09 : string;
  attribute INIT_0A : string;
  attribute INIT_0B : string;
  attribute INIT_0C : string;
  attribute INIT_0D : string;
  attribute INIT_0E : string;
  attribute INIT_0F : string;
  attribute INIT_10 : string;
  attribute INIT_11 : string;
  attribute INIT_12 : string;
  attribute INIT_13 : string;
  attribute INIT_14 : string;
  attribute INIT_15 : string;
  attribute INIT_16 : string;
  attribute INIT_17 : string;
  attribute INIT_18 : string;
  attribute INIT_19 : string;
  attribute INIT_1A : string;
  attribute INIT_1B : string;
  attribute INIT_1C : string;
  attribute INIT_1D : string;
  attribute INIT_1E : string;
  attribute INIT_1F : string;
  attribute INIT_20 : string;
  attribute INIT_21 : string;
  attribute INIT_22 : string;
  attribute INIT_23 : string;
  attribute INIT_24 : string;
  attribute INIT_25 : string;
  attribute INIT_26 : string;
  attribute INIT_27 : string;
  attribute INIT_28 : string;
  attribute INIT_29 : string;
  attribute INIT_2A : string;
  attribute INIT_2B : string;
  attribute INIT_2C : string;
  attribute INIT_2D : string;
  attribute INIT_2E : string;
  attribute INIT_2F : string;
  attribute INIT_30 : string;
  attribute INIT_31 : string;
  attribute INIT_32 : string;
  attribute INIT_33 : string;
  attribute INIT_34 : string;
  attribute INIT_35 : string;
  attribute INIT_36 : string;
  attribute INIT_37 : string;
  attribute INIT_38 : string;
  attribute INIT_39 : string;
  attribute INIT_3A : string;
  attribute INIT_3B : string;
  attribute INIT_3C : string;
  attribute INIT_3D : string;
  attribute INIT_3E : string;
  attribute INIT_3F : string;

  component RAMB16_S2
    --pragma translate_off
    generic (
      INIT_00 : bit_vector (255 downto 0) := x"0000000000000000000000000000000000000000000000000000000000000000";
      INIT_01 : bit_vector (255 downto 0) := x"0000000000000000000000000000000000000000000000000000000000000000";
      INIT_02 : bit_vector (255 downto 0) := x"0000000000000000000000000000000000000000000000000000000000000000";
      INIT_03 : bit_vector (255 downto 0) := x"0000000000000000000000000000000000000000000000000000000000000000";
      INIT_04 : bit_vector (255 downto 0) := x"0000000000000000000000000000000000000000000000000000000000000000";
      INIT_05 : bit_vector (255 downto 0) := x"0000000000000000000000000000000000000000000000000000000000000000";
      INIT_06 : bit_vector (255 downto 0) := x"0000000000000000000000000000000000000000000000000000000000000000";
      INIT_07 : bit_vector (255 downto 0) := x"0000000000000000000000000000000000000000000000000000000000000000";
      INIT_08 : bit_vector (255 downto 0) := x"0000000000000000000000000000000000000000000000000000000000000000";
      INIT_09 : bit_vector (255 downto 0) := x"0000000000000000000000000000000000000000000000000000000000000000";
      INIT_0A : bit_vector (255 downto 0) := x"0000000000000000000000000000000000000000000000000000000000000000";
      INIT_0B : bit_vector (255 downto 0) := x"0000000000000000000000000000000000000000000000000000000000000000";
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
    attribute INIT_34 of inst : label is "0202630C0000000080A0330C00000000AA82818C0000000080A0330C00000000";
    attribute INIT_35 of inst : label is "8280CD5300000000A0280CC3000000002A02958C0000000080A0330C00000000";
    attribute INIT_36 of inst : label is "00003FE007FF000000002FF0FF4000000FFF3FE007FF000040000000E0000000";
    attribute INIT_37 of inst : label is "0FE03FFC07FF00002FC0FFF0FF4000000FFF3FEA07FF0000FFC00000FF400000";
    attribute INIT_38 of inst : label is "0B0A032603546000B9C0E630350100090FFF3FFF07FF0000FFC0FFF0FF400000";
    attribute INIT_39 of inst : label is "3FFF1FC701FF2028FD00FC74FF4000003FFF1FFF010F2028FD00FFF4F0400000";
    attribute INIT_3A of inst : label is "0AFEFFD400000000FE805FFC0000000002BF3FF414000000FA007FF000500000";
    attribute INIT_3B of inst : label is "2BFE550000000000FFA00154000000000AFEFD5000000000FE8015FC00000000";
    attribute INIT_3C of inst : label is "7FFF000000000000FFF4000000000000BFFF000000000000FFF8000000000000";
    attribute INIT_3D of inst : label is "003F0000000000A8F00000000000A80001FF000000000AA0FD00000000002A80";
    attribute INIT_3E of inst : label is "00030000000000000000000000000000000F000000000008C000000000008000";
    attribute INIT_3F of inst : label is "000000000000000000000000000000000A000124000000180140600000009200";
  begin
  inst : RAMB16_S2
      --pragma translate_off
      generic map (
        INIT_00 => romgen_str2bv(inst'INIT_00),
        INIT_01 => romgen_str2bv(inst'INIT_01),
        INIT_02 => romgen_str2bv(inst'INIT_02),
        INIT_03 => romgen_str2bv(inst'INIT_03),
        INIT_04 => romgen_str2bv(inst'INIT_04),
        INIT_05 => romgen_str2bv(inst'INIT_05),
        INIT_06 => romgen_str2bv(inst'INIT_06),
        INIT_07 => romgen_str2bv(inst'INIT_07),
        INIT_08 => romgen_str2bv(inst'INIT_08),
        INIT_09 => romgen_str2bv(inst'INIT_09),
        INIT_0A => romgen_str2bv(inst'INIT_0A),
        INIT_0B => romgen_str2bv(inst'INIT_0B),
        INIT_0C => romgen_str2bv(inst'INIT_0C),
        INIT_0D => romgen_str2bv(inst'INIT_0D),
        INIT_0E => romgen_str2bv(inst'INIT_0E),
        INIT_0F => romgen_str2bv(inst'INIT_0F),
        INIT_10 => romgen_str2bv(inst'INIT_10),
        INIT_11 => romgen_str2bv(inst'INIT_11),
        INIT_12 => romgen_str2bv(inst'INIT_12),
        INIT_13 => romgen_str2bv(inst'INIT_13),
        INIT_14 => romgen_str2bv(inst'INIT_14),
        INIT_15 => romgen_str2bv(inst'INIT_15),
        INIT_16 => romgen_str2bv(inst'INIT_16),
        INIT_17 => romgen_str2bv(inst'INIT_17),
        INIT_18 => romgen_str2bv(inst'INIT_18),
        INIT_19 => romgen_str2bv(inst'INIT_19),
        INIT_1A => romgen_str2bv(inst'INIT_1A),
        INIT_1B => romgen_str2bv(inst'INIT_1B),
        INIT_1C => romgen_str2bv(inst'INIT_1C),
        INIT_1D => romgen_str2bv(inst'INIT_1D),
        INIT_1E => romgen_str2bv(inst'INIT_1E),
        INIT_1F => romgen_str2bv(inst'INIT_1F),
        INIT_20 => romgen_str2bv(inst'INIT_20),
        INIT_21 => romgen_str2bv(inst'INIT_21),
        INIT_22 => romgen_str2bv(inst'INIT_22),
        INIT_23 => romgen_str2bv(inst'INIT_23),
        INIT_24 => romgen_str2bv(inst'INIT_24),
        INIT_25 => romgen_str2bv(inst'INIT_25),
        INIT_26 => romgen_str2bv(inst'INIT_26),
        INIT_27 => romgen_str2bv(inst'INIT_27),
        INIT_28 => romgen_str2bv(inst'INIT_28),
        INIT_29 => romgen_str2bv(inst'INIT_29),
        INIT_2A => romgen_str2bv(inst'INIT_2A),
        INIT_2B => romgen_str2bv(inst'INIT_2B),
        INIT_2C => romgen_str2bv(inst'INIT_2C),
        INIT_2D => romgen_str2bv(inst'INIT_2D),
        INIT_2E => romgen_str2bv(inst'INIT_2E),
        INIT_2F => romgen_str2bv(inst'INIT_2F),
        INIT_30 => romgen_str2bv(inst'INIT_30),
        INIT_31 => romgen_str2bv(inst'INIT_31),
        INIT_32 => romgen_str2bv(inst'INIT_32),
        INIT_33 => romgen_str2bv(inst'INIT_33),
        INIT_34 => romgen_str2bv(inst'INIT_34),
        INIT_35 => romgen_str2bv(inst'INIT_35),
        INIT_36 => romgen_str2bv(inst'INIT_36),
        INIT_37 => romgen_str2bv(inst'INIT_37),
        INIT_38 => romgen_str2bv(inst'INIT_38),
        INIT_39 => romgen_str2bv(inst'INIT_39),
        INIT_3A => romgen_str2bv(inst'INIT_3A),
        INIT_3B => romgen_str2bv(inst'INIT_3B),
        INIT_3C => romgen_str2bv(inst'INIT_3C),
        INIT_3D => romgen_str2bv(inst'INIT_3D),
        INIT_3E => romgen_str2bv(inst'INIT_3E),
        INIT_3F => romgen_str2bv(inst'INIT_3F)
        )
      --pragma translate_on
      port map (
        DO   => DATA(1 downto 0),
        ADDR => rom_addr,
        CLK  => CLK,
        DI   => "00",
        EN   => ENA,
        SSR  => '0',
        WE   => '0'
        );
  end generate;
  rom1 : if true generate
    attribute INIT_00 of inst : label is "155501E001543EAD1554000F00543D7D055502AD055407F8005000F001503C0F";
    attribute INIT_01 of inst : label is "15553EA805550FA815503C0F01543C0015543EAD01503D5F05540AAF05501AF5";
    attribute INIT_02 of inst : label is "00000000000000001FF4FFFF1FF4FFFF00000BE000000BE00000028000000280";
    attribute INIT_03 of inst : label is "0000000000000000000000000000000000000000000000000000000000000000";
    attribute INIT_04 of inst : label is "0F3C00000F3C000000001400000000000017002AFFC0A000000002BF0000FF40";
    attribute INIT_05 of inst : label is "00000000D000F00007FF0F007FFFF000FFD0F0F0D0FFF0F003FF0FAAFFFDF00F";
    attribute INIT_06 of inst : label is "3EAF03C007A83C0F3EA8140F01FC2ABE0ABE140F1EAD1FA001F000F006B42D0E";
    attribute INIT_07 of inst : label is "C000C000EAAAC00000030003AAAB000300000000000606001EAD001E1EA430AF";
    attribute INIT_08 of inst : label is "07AA2D0F3EAA3C000FAA0F003EB43C1E07AD2D053EAD3C0F07B43EAF00000000";
    attribute INIT_09 of inst : label is "1EAD3C0F3D0F3CBF3D1F3C8F0F000F003C1E3EF4000F140F0AFA00F03C0F3C0F";
    attribute INIT_0A of inst : label is "3C0F3FBF3C0F0BF83C0F3C0F0AFA00F01EB4140F3EAD3EF41EAD3CBE3EAD3EA8";
    attribute INIT_0B of inst : label is "000040000000C02A0000EA001AA4C94300FC02002ABF1F800F0F00F03D1F1FBD";
    attribute INIT_0C of inst : label is "003F00000000003FFFFF00000000FF503FFF000000003FF40003000000000000";
    attribute INIT_0D of inst : label is "000000000000000001FF00000000000003FF0000000003FFFFFF00000000D400";
    attribute INIT_0E of inst : label is "0000000000000000000000000000000000000000000000000000000000000000";
    attribute INIT_0F of inst : label is "0000000000000000000000000000000000000000000000000000000000000000";
    attribute INIT_10 of inst : label is "00060001706930C391A4330CEAC60C0CEA8640CCAB8640CC0706030C00000000";
    attribute INIT_11 of inst : label is "00000000900030001A4630CCA8690CC3000E0004B8690CC3000A0004A46980C3";
    attribute INIT_12 of inst : label is "0BFF002BFF80A000000007D400005F400FF90002CF40FF800000000000000000";
    attribute INIT_13 of inst : label is "03DF0EAAFFC0FAB0000000FB0000FF000FFF02BFFFF0FE800000005700005500";
    attribute INIT_14 of inst : label is "00E1000663400600001000000000C0000FFF00BEFFF0FE0000000FFD0000FFD0";
    attribute INIT_15 of inst : label is "000C000CE000E00000000000000000000BFB0003BF80000000000C00000000C0";
    attribute INIT_16 of inst : label is "00000000000000003E2C000038BC0000FFA0FFFC0FFA3FFF0000F5000000005F";
    attribute INIT_17 of inst : label is "0000000000000000000000000000000000000000000000000000000000000000";
    attribute INIT_18 of inst : label is "0000000000000000000000000000000000000000000000000000000000000000";
    attribute INIT_19 of inst : label is "0000000000000000000000000000000000000000000000000000000000000000";
    attribute INIT_1A of inst : label is "C300C02A00C3A803C300302A00C3A80CC300C30000C300C305AAC180AA500243";
    attribute INIT_1B of inst : label is "0000AAAA0000AAAA0000AAAA0000AAAAAAAA0000AAAA0000C000C18000030243";
    attribute INIT_1C of inst : label is "0000001A0000A4000000000000000000000005AA0000AA5030000000000C0000";
    attribute INIT_1D of inst : label is "00C2000083000000000000EA0000AB0000C000000300000000C000C003000300";
    attribute INIT_1E of inst : label is "0000001A0000A40000C0A8000300002A00000240000001800000AAAB0000EAAA";
    attribute INIT_1F of inst : label is "00000000000000000000000000000000AAAA0240AAAA018000C0000003000000";
    attribute INIT_20 of inst : label is "0BFF07D40000002BFF805F400000A0000FF9000000000002CF4000000000FF80";
    attribute INIT_21 of inst : label is "03DF00FB00000EAAFFC0FF000000FAB00FFF0057000002BFFFF055000000FE80";
    attribute INIT_22 of inst : label is "00E10000001000066340C000000006000FFF0FFD000000BEFFF0FFD00000FE00";
    attribute INIT_23 of inst : label is "000C00000000000CE00000000000E0000BFB0C0000000003BF8000C000000000";
    attribute INIT_24 of inst : label is "3FFF0FFF00053FEFFFFCFFF05000FBFC3FFF0FFF00053EFEFFFCFFF05000BFBC";
    attribute INIT_25 of inst : label is "00070000000003FFFFC078E00000FFFC007F000000000FFFFF8078E00000FFC0";
    attribute INIT_26 of inst : label is "0000000000001F550000000000005FF40000000000001FD7000000000000FFD0";
    attribute INIT_27 of inst : label is "0000000000000000000000000000000000000000000000000000000000000000";
    attribute INIT_28 of inst : label is "F800FFF8FF54000000000000000000001FFF007F0000FFFFFFFFFFFF15FFFFF8";
    attribute INIT_29 of inst : label is "FF4040000000FFFF00000000000000000BFF3FFFFFFF000BFFFFFFFFFF40FFFF";
    attribute INIT_2A of inst : label is "FFFFFFFFFF54FA80FFA0FD00000000001FFF007F0000FFFFFFFFFFFF15FFFFFF";
    attribute INIT_2B of inst : label is "FFFFFFFF0000FFFFFFE050000000E0000BFF3FFFFFFF000BFFFFFFFFFFF5FFFF";
    attribute INIT_2C of inst : label is "FFFFFFFFFF54FFFFFFF4FD000000FFFF1FFF007F0000FFFFFFFFFFFF15FFFFFF";
    attribute INIT_2D of inst : label is "FFFFFFFFFFFFFFFFFFE0FFFCFFFFE0000BFF3FFFFFFF000BFFFFFFFFFFFFFFFF";
    attribute INIT_2E of inst : label is "0000000000000000000000000000000000000000000000000000000000000000";
    attribute INIT_2F of inst : label is "0000000000000000000000000000000000000000000000000000000000000000";
    attribute INIT_30 of inst : label is "3FFF0FFF00053FEFFFFCFFF05000FBFC3FFF0FFF00053EFEFFFCFFF05000BFBC";
    attribute INIT_31 of inst : label is "3F0F0FFF00053FEFF0FCFFF05000FBFC3F0F0FFF00053EFEF0FCFFF05000BFBC";
    attribute INIT_32 of inst : label is "3FFF0FFF00053FEFFFFCFFF05000FBFC3FFF0FFF00053EFEFFFCFFF05000BFBC";
    attribute INIT_33 of inst : label is "3FFF0FFF00053FEFFFFCFFF05000FBFC3FFF0FFF00053EFEFFFCFFF05000BFBC";
    attribute INIT_34 of inst : label is "AB8C070600000000330C91A400000000180C6A4600000000330C91A400000000";
    attribute INIT_35 of inst : label is "CC33C6A1000000000CC3A46900000000C0CC6A4600000000330C91A400000000";
    attribute INIT_36 of inst : label is "3E001FFE0015000002F0FFD0500000003FF41FFE001502BF000000005000F000";
    attribute INIT_37 of inst : label is "3FF01FFF001502803FF0FFD050000A003FFF1FFF001502BF5400FE805000FA00";
    attribute INIT_38 of inst : label is "0CF401CD240007961980A698060096D03FFF1FFF001502BFFFF0FFD05000FA00";
    attribute INIT_39 of inst : label is "3FFF0FFF00053EFEFF80FFF05000B8003FFF0FFF00053EFEFF80FFF05000B800";
    attribute INIT_3A of inst : label is "3FFF750000000000FFF00174000000000FFF3F4000000000FFC007F000000000";
    attribute INIT_3B of inst : label is "FFFF000000000000FFFC000000000000BFFF000000000000FFF8000000000000";
    attribute INIT_3C of inst : label is "005F000000002BF8D40000000000BFA055FF0000000002A8FD5400000000AA00";
    attribute INIT_3D of inst : label is "00070000000001FF400000000000FD000007000000003FFE400000000000FFF0";
    attribute INIT_3E of inst : label is "00030000000000030000000000000000000300000000001F000000000000D000";
    attribute INIT_3F of inst : label is "0000000000000000000000000000000000800000000001800600000000000400";
  begin
  inst : RAMB16_S2
      --pragma translate_off
      generic map (
        INIT_00 => romgen_str2bv(inst'INIT_00),
        INIT_01 => romgen_str2bv(inst'INIT_01),
        INIT_02 => romgen_str2bv(inst'INIT_02),
        INIT_03 => romgen_str2bv(inst'INIT_03),
        INIT_04 => romgen_str2bv(inst'INIT_04),
        INIT_05 => romgen_str2bv(inst'INIT_05),
        INIT_06 => romgen_str2bv(inst'INIT_06),
        INIT_07 => romgen_str2bv(inst'INIT_07),
        INIT_08 => romgen_str2bv(inst'INIT_08),
        INIT_09 => romgen_str2bv(inst'INIT_09),
        INIT_0A => romgen_str2bv(inst'INIT_0A),
        INIT_0B => romgen_str2bv(inst'INIT_0B),
        INIT_0C => romgen_str2bv(inst'INIT_0C),
        INIT_0D => romgen_str2bv(inst'INIT_0D),
        INIT_0E => romgen_str2bv(inst'INIT_0E),
        INIT_0F => romgen_str2bv(inst'INIT_0F),
        INIT_10 => romgen_str2bv(inst'INIT_10),
        INIT_11 => romgen_str2bv(inst'INIT_11),
        INIT_12 => romgen_str2bv(inst'INIT_12),
        INIT_13 => romgen_str2bv(inst'INIT_13),
        INIT_14 => romgen_str2bv(inst'INIT_14),
        INIT_15 => romgen_str2bv(inst'INIT_15),
        INIT_16 => romgen_str2bv(inst'INIT_16),
        INIT_17 => romgen_str2bv(inst'INIT_17),
        INIT_18 => romgen_str2bv(inst'INIT_18),
        INIT_19 => romgen_str2bv(inst'INIT_19),
        INIT_1A => romgen_str2bv(inst'INIT_1A),
        INIT_1B => romgen_str2bv(inst'INIT_1B),
        INIT_1C => romgen_str2bv(inst'INIT_1C),
        INIT_1D => romgen_str2bv(inst'INIT_1D),
        INIT_1E => romgen_str2bv(inst'INIT_1E),
        INIT_1F => romgen_str2bv(inst'INIT_1F),
        INIT_20 => romgen_str2bv(inst'INIT_20),
        INIT_21 => romgen_str2bv(inst'INIT_21),
        INIT_22 => romgen_str2bv(inst'INIT_22),
        INIT_23 => romgen_str2bv(inst'INIT_23),
        INIT_24 => romgen_str2bv(inst'INIT_24),
        INIT_25 => romgen_str2bv(inst'INIT_25),
        INIT_26 => romgen_str2bv(inst'INIT_26),
        INIT_27 => romgen_str2bv(inst'INIT_27),
        INIT_28 => romgen_str2bv(inst'INIT_28),
        INIT_29 => romgen_str2bv(inst'INIT_29),
        INIT_2A => romgen_str2bv(inst'INIT_2A),
        INIT_2B => romgen_str2bv(inst'INIT_2B),
        INIT_2C => romgen_str2bv(inst'INIT_2C),
        INIT_2D => romgen_str2bv(inst'INIT_2D),
        INIT_2E => romgen_str2bv(inst'INIT_2E),
        INIT_2F => romgen_str2bv(inst'INIT_2F),
        INIT_30 => romgen_str2bv(inst'INIT_30),
        INIT_31 => romgen_str2bv(inst'INIT_31),
        INIT_32 => romgen_str2bv(inst'INIT_32),
        INIT_33 => romgen_str2bv(inst'INIT_33),
        INIT_34 => romgen_str2bv(inst'INIT_34),
        INIT_35 => romgen_str2bv(inst'INIT_35),
        INIT_36 => romgen_str2bv(inst'INIT_36),
        INIT_37 => romgen_str2bv(inst'INIT_37),
        INIT_38 => romgen_str2bv(inst'INIT_38),
        INIT_39 => romgen_str2bv(inst'INIT_39),
        INIT_3A => romgen_str2bv(inst'INIT_3A),
        INIT_3B => romgen_str2bv(inst'INIT_3B),
        INIT_3C => romgen_str2bv(inst'INIT_3C),
        INIT_3D => romgen_str2bv(inst'INIT_3D),
        INIT_3E => romgen_str2bv(inst'INIT_3E),
        INIT_3F => romgen_str2bv(inst'INIT_3F)
        )
      --pragma translate_on
      port map (
        DO   => DATA(3 downto 2),
        ADDR => rom_addr,
        CLK  => CLK,
        DI   => "00",
        EN   => ENA,
        SSR  => '0',
        WE   => '0'
        );
  end generate;
  rom2 : if true generate
    attribute INIT_00 of inst : label is "281E03C01E002D5E3D542D5E07BC003C00782D5E281F3F5502F005F51C2D0B58";
    attribute INIT_01 of inst : label is "3C003C000F000F553C2D3D781E0A0B5E3C0F3D5E1E2D3C0F3C0F05783D0C255E";
    attribute INIT_02 of inst : label is "0000000000000000000000000000000000000000000000000000000000000000";
    attribute INIT_03 of inst : label is "0000000000000000000000000000000000000000000000000000000000000000";
    attribute INIT_04 of inst : label is "0618000006180000000028000000000002FF0000FE000000007F0002F400BFC0";
    attribute INIT_05 of inst : label is "00000000F000E0000F000BFFF000BFFFF0F0F0F0F0F0F0F005550FFFF00FF00F";
    attribute INIT_06 of inst : label is "007802803D540AA82AAD0AA81E3C002801F40AA8017E2AAA00F00AAA3C0F02A0";
    attribute INIT_07 of inst : label is "C000D555C000C000000355570003000301500000006020002D5F0AA02F580AA8";
    attribute INIT_08 of inst : label is "3C1502AA3D5428000F540AAA3C0F2AA03C0002A83D5E2AA83C0F280A00000000";
    attribute INIT_09 of inst : label is "3C0F0AA83FDF280A3FFF280A0F000AAA3DE0282A000F0AA800F00AAA3D5F280A";
    attribute INIT_0A of inst : label is "3DDF280A3D1F00803C0F0AA800F000A02D540AA83C1F282A3C0F0AA23C0F2800";
    attribute INIT_0B of inst : label is "80000000E86A80AAEA4A8000C683255803E0080001F82AAA0B5E00A00BF8280A";
    attribute INIT_0C of inst : label is "002A0000003F003FAAAA0000F400FFFF2AAA00003FC03FFF0000000000000000";
    attribute INIT_0D of inst : label is "00000000000000002AA800000000000702AA000003FD03FFAAAA00000000FFFF";
    attribute INIT_0E of inst : label is "0000000000000000000000000000000000000000000000000000000000000000";
    attribute INIT_0F of inst : label is "0000000000000000000000000000000000000000000000000000000000000000";
    attribute INIT_10 of inst : label is "0008000A30C3A828330C80A0030C0802AA4C2A02090C2A02030C0A8200000000";
    attribute INIT_11 of inst : label is "000000003000800030CC0A02A4C3A028000A000290C3A0280000000218C3A828";
    attribute INIT_12 of inst : label is "0004000010000000005702115400200000800000400000000000001805F01800";
    attribute INIT_13 of inst : label is "000002AA0000AA8000000000000000000000000000000000000100027D400000";
    attribute INIT_14 of inst : label is "02DB00029BE08000000000D90000F9C000000000080000000001000080000000";
    attribute INIT_15 of inst : label is "000C000240000000005A00AE9400E8000003000000000000000103FF0000FF00";
    attribute INIT_16 of inst : label is "00000000000000000000000000000000F4BCFFFC3F4B3FFF0000FE90000007EB";
    attribute INIT_17 of inst : label is "0000000000000000000000000000000000000000000000000000000000000000";
    attribute INIT_18 of inst : label is "0000000000000000000000000000000000000000000000000000000000000000";
    attribute INIT_19 of inst : label is "0000AAAA0000AAAA000000000000000000000000000000000000000000000000";
    attribute INIT_1A of inst : label is "FF40FFFF01FFFFFFFF400AFF01FFFFA0FF00FF0000FF00FF3FFFFF00FFFC00FF";
    attribute INIT_1B of inst : label is "0000FFFF0000FFFF0000FFFF0000FFFFFFFF0000FFFF0000FFFFFF00FFFF00FF";
    attribute INIT_1C of inst : label is "000000FF0000FF00FFFF0000FFFF000000003FFF0000FFFC0AFF0000FFA00000";
    attribute INIT_1D of inst : label is "00FF0000FF000000000000FF0000FF00002F0000F800000000FF00FFFF00FF00";
    attribute INIT_1E of inst : label is "000000FF0000FF0001FFFFFFFF40FFFFFFFF00FFFFFFFF000000FFFF0000FFFF";
    attribute INIT_1F of inst : label is "00000000000000000000000000000000FFFF00FFFFFFFF00002F0000F8000000";
    attribute INIT_20 of inst : label is "0004021100570000100020005400000000800018000000004000180005F00000";
    attribute INIT_21 of inst : label is "00000000000002AA000000000000AA800000000200010000000000007D400000";
    attribute INIT_22 of inst : label is "02DB00D9000000029BE0F9C00000800000000000000100000800000080000000";
    attribute INIT_23 of inst : label is "000C00AE005A00024000E80094000000000303FF000100000000FF0000000000";
    attribute INIT_24 of inst : label is "3FFF1F0F01FF0A02F6FCF0F4FF4080A03FFF1F0F01FF2028F6FCF0F4FF402008";
    attribute INIT_25 of inst : label is "003F0001000002A0FFC04B28000000A803FF000100000A80FE004B2800000A80";
    attribute INIT_26 of inst : label is "000000000000AAAA000000000000AAA0000000000000AAAA150000000000AA80";
    attribute INIT_27 of inst : label is "0000000000000000000000000000000000000000000000000000000000000000";
    attribute INIT_28 of inst : label is "0000000000000000000000000000000000000000000000000000000000000000";
    attribute INIT_29 of inst : label is "0000000000000000000000000000000000000000000000000000000000000000";
    attribute INIT_2A of inst : label is "0000000000000000000000000000000000000000000000000000000000000000";
    attribute INIT_2B of inst : label is "0000000000000000000000000000000000000000000000000000000000000000";
    attribute INIT_2C of inst : label is "0000000000000000000000000000000000000000000000000000000000000000";
    attribute INIT_2D of inst : label is "0000000000000000000000000000000000000000000000000000000000000000";
    attribute INIT_2E of inst : label is "3FFF1FFF01FF0A02FFFCFFF4FF4080A03FFF1FFF01FF2028FFFCFFF4FF402808";
    attribute INIT_2F of inst : label is "0000000000000000000000000000000000000000000000000000000000000000";
    attribute INIT_30 of inst : label is "3FFF1F0F01FF0A02FFFCF0F4FF4080A03FFF1F0F01FF2028FFFCF0F4FF402808";
    attribute INIT_31 of inst : label is "3FFF1C0301FF0A02FFFCC034FF4080A03FFF1C0301FF2028FFFCC034FF402808";
    attribute INIT_32 of inst : label is "3FFF1F0F01FF0A02FFFCF0F4FF4080A03FFF1F0F01FF2028FFFCF0F4FF402808";
    attribute INIT_33 of inst : label is "3FFF1F5F00FB0A02FFFCF5F4EF0080A03FFF1F5F00FB2028FFFCF5F4EF002808";
    attribute INIT_34 of inst : label is "0000000000000000000000000000000000000000000000000000000000000000";
    attribute INIT_35 of inst : label is "0000000000000000000000000000000000000000000000000000000000000000";
    attribute INIT_36 of inst : label is "00003FE007FF000000002FF0FF4000000FFF3FE007FF000040000000E0000000";
    attribute INIT_37 of inst : label is "0FE03FFC07FF00002FC0FFF0FF4000000FFF3FEA07FF0000FFC00000FF400000";
    attribute INIT_38 of inst : label is "02CB00F600000000FB00EFC0000000000FFF3FFF07FF0000FFC0FFF0FF400000";
    attribute INIT_39 of inst : label is "3FFF1D0701AF2028FFF0D074FA400AA83FFF1F5F000B2028FFF0F5F4E0000AA8";
    attribute INIT_3A of inst : label is "0AFEFFD400000000FE805FFC0000000002BF3FF414000000FA007FF000500000";
    attribute INIT_3B of inst : label is "2BFE550000000000FFA00154000000000AFEFD5000000000FE8015FC00000000";
    attribute INIT_3C of inst : label is "7FFF000000000000FFF4000000000000BFFF000000000000FFF8000000000000";
    attribute INIT_3D of inst : label is "003F0000000000A8F00000000000A80001FF000000000AA0FD00000000002A80";
    attribute INIT_3E of inst : label is "00030000000000000000000000000000000F000000000008C000000000008000";
    attribute INIT_3F of inst : label is "000000000000000000000000000000000A000124000000180140600000009200";
  begin
  inst : RAMB16_S2
      --pragma translate_off
      generic map (
        INIT_00 => romgen_str2bv(inst'INIT_00),
        INIT_01 => romgen_str2bv(inst'INIT_01),
        INIT_02 => romgen_str2bv(inst'INIT_02),
        INIT_03 => romgen_str2bv(inst'INIT_03),
        INIT_04 => romgen_str2bv(inst'INIT_04),
        INIT_05 => romgen_str2bv(inst'INIT_05),
        INIT_06 => romgen_str2bv(inst'INIT_06),
        INIT_07 => romgen_str2bv(inst'INIT_07),
        INIT_08 => romgen_str2bv(inst'INIT_08),
        INIT_09 => romgen_str2bv(inst'INIT_09),
        INIT_0A => romgen_str2bv(inst'INIT_0A),
        INIT_0B => romgen_str2bv(inst'INIT_0B),
        INIT_0C => romgen_str2bv(inst'INIT_0C),
        INIT_0D => romgen_str2bv(inst'INIT_0D),
        INIT_0E => romgen_str2bv(inst'INIT_0E),
        INIT_0F => romgen_str2bv(inst'INIT_0F),
        INIT_10 => romgen_str2bv(inst'INIT_10),
        INIT_11 => romgen_str2bv(inst'INIT_11),
        INIT_12 => romgen_str2bv(inst'INIT_12),
        INIT_13 => romgen_str2bv(inst'INIT_13),
        INIT_14 => romgen_str2bv(inst'INIT_14),
        INIT_15 => romgen_str2bv(inst'INIT_15),
        INIT_16 => romgen_str2bv(inst'INIT_16),
        INIT_17 => romgen_str2bv(inst'INIT_17),
        INIT_18 => romgen_str2bv(inst'INIT_18),
        INIT_19 => romgen_str2bv(inst'INIT_19),
        INIT_1A => romgen_str2bv(inst'INIT_1A),
        INIT_1B => romgen_str2bv(inst'INIT_1B),
        INIT_1C => romgen_str2bv(inst'INIT_1C),
        INIT_1D => romgen_str2bv(inst'INIT_1D),
        INIT_1E => romgen_str2bv(inst'INIT_1E),
        INIT_1F => romgen_str2bv(inst'INIT_1F),
        INIT_20 => romgen_str2bv(inst'INIT_20),
        INIT_21 => romgen_str2bv(inst'INIT_21),
        INIT_22 => romgen_str2bv(inst'INIT_22),
        INIT_23 => romgen_str2bv(inst'INIT_23),
        INIT_24 => romgen_str2bv(inst'INIT_24),
        INIT_25 => romgen_str2bv(inst'INIT_25),
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
