Saanlima/Pepino/(commit log)

2016-02-12 Adding ISE project
    [ols.profile-pepino-1M.cfg]
2016-02-24 Updated the code to use DDR output driver for write enable
2016-03-02 Switched over to use MouseM.v
2016-04-03 Added UART_echo project
2016-04-11 Updated the README, fixed some typos
    [Snake.v]
2020-05-03 Added board files
    [pepino4.GBL, pepino4.GBO, pepino4.GBP, pepino4.GBS, pepino4.GTL, pepino4.GTO, pepino4.GTP, pepino4.GTS]
