Saanlima/Pepino/(notices)

Notices in the files:
Projects/OLS_SRAM_edgetriggers_buffer/verilog/controller.v:
This program is free software; you can redistribute it and/or modify
the Free Software Foundation; either version 2 of the License, or (at
Board/eagle/pepino4.brd:
Copyright 2015 Saanlima Electronics
parts and their libraries:
SparkFun-Connectors: Licensing: Creative Commons ShareAlike 4.0 International - https://creativecommons.org/licenses/by-sa/4.0
